ISU-Research/Hydra1-Orbital-Greenhouse/Raw images/Ground/Img-2018-12-22 05_48_20.033600.png

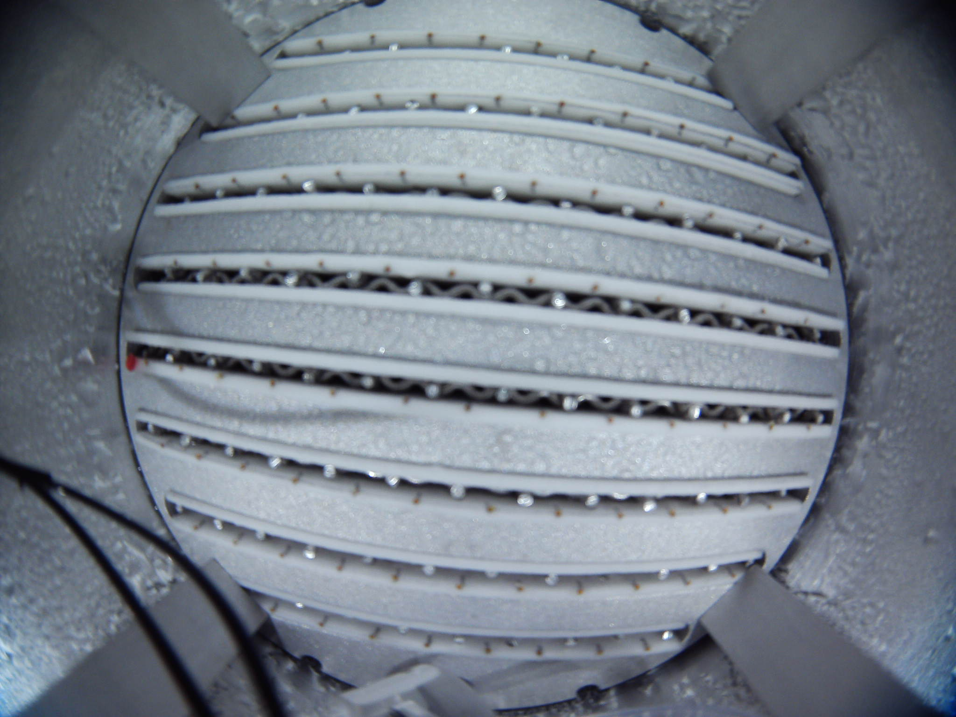
Raw images/Ground/Img-2018-12-22 05_48_20.033600.png
