ISU-Research/Hydra1-Orbital-Greenhouse/Publication/Supplementary figure 1.docx

Supplementary figure 1. The greenness index was calculated for samples of the metal cassette and filter paper to verify that the trends observed for the leaves were not due to imaging factors. The trends are flat but there is a small difference between the transgenic and wildtype values. The direction of this difference is opposite in the ground and flight cubes and may be a result of the asymmetry in the PCB design.
