ISU-Research/Hydra1-Orbital-Greenhouse/Engineering files/Hydra 1 PCB files/Electrical connections inside the cube.pdf

Electrical connections inside the cube

This document details the connection between hermetically sealed connector and the Fisher electronic connector on the PCB.

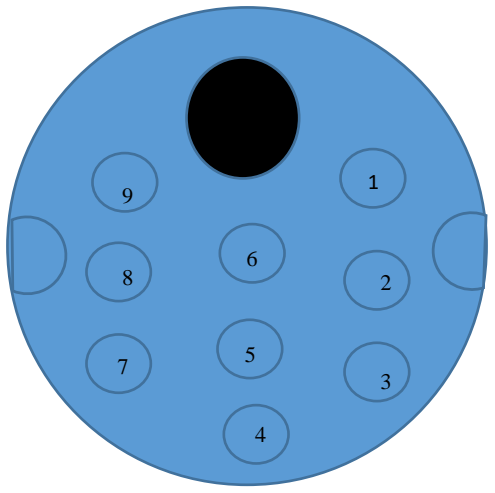
[picture p8: figure]

Figure 1 Front View of the hermitically sealed connector.

Table below enlists the connection.

Pin1 | 5V
Pin 2 | DM
Pin3 | DP
Pin4 | GND
Pin5 | 3.3 V
Pin6 | Temperature Sensor
Pin7 | Valve
1 | 2 3 | 4 | 5 | 6 7 | 9 | 8 | NC

Figure 2 Fisher electronic male connector in out

Pin 8 | Growth LED
Pin 9 | White LED

Table below lists the connection for four pin header

Pin 1 | GND
Pin 2 | DP
Pin 3 | DM
Pin 4 | 5V

Figure below illustrates the orientation of the Header P1 and camera Header

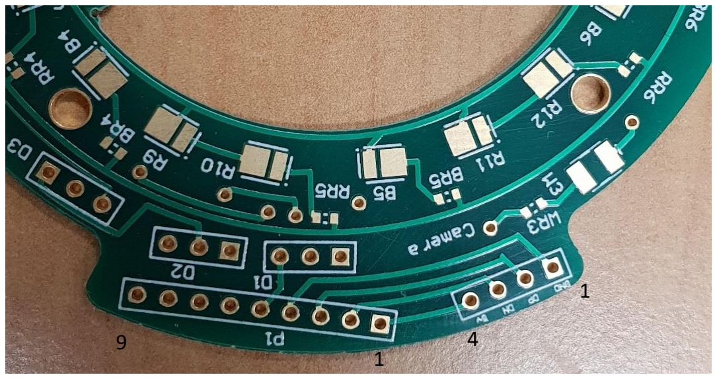
[picture p9: figure]
