ISU-Research/Hydra1-Orbital-Greenhouse/Image analysis/Flight/flight_mask.png

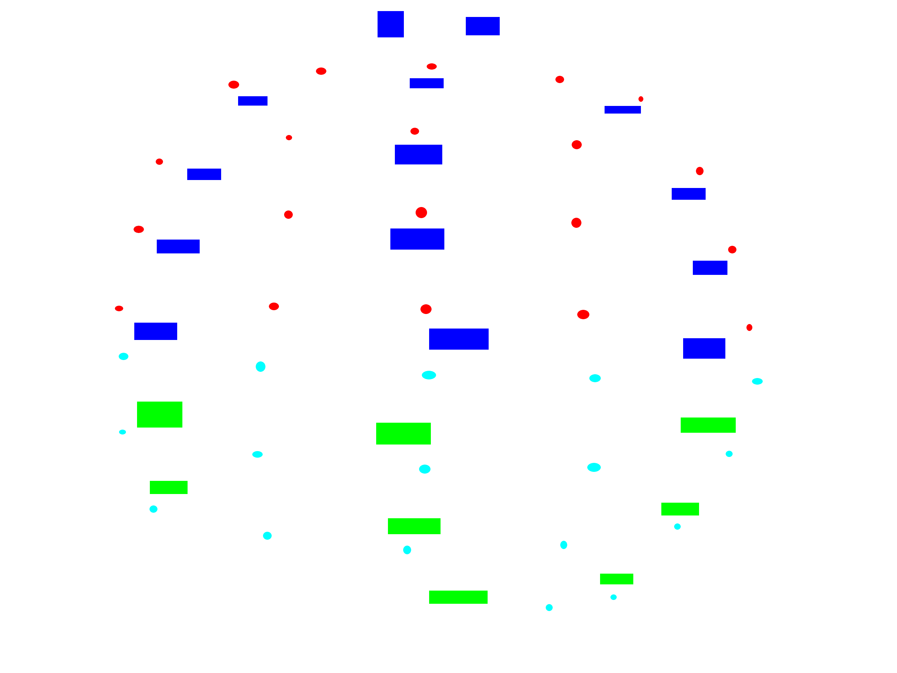
Image analysis/Flight/flight_mask.png
