ISU-Research/Hydra1-Orbital-Greenhouse/Image analysis/Flight/Img-2018-12-24 01_41_35.710161_paste.png

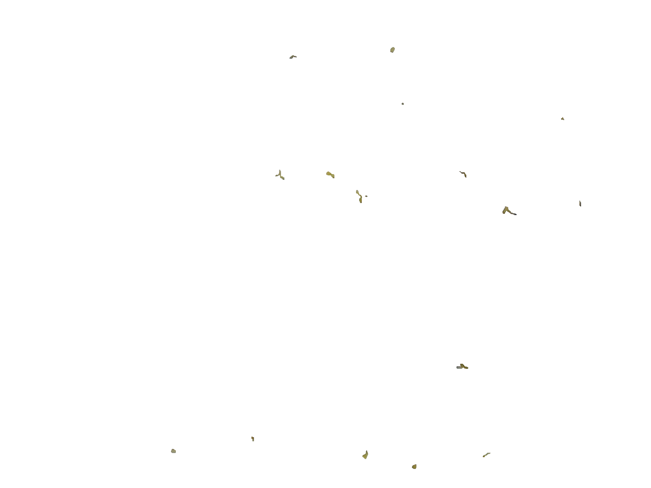
Image analysis/Flight/Img-2018-12-24 01_41_35.710161_paste.png
