ISU-Research/Hydra1-Orbital-Greenhouse/Image analysis/Flight/Img-2018-12-24 17_42_14.649429_paste.png

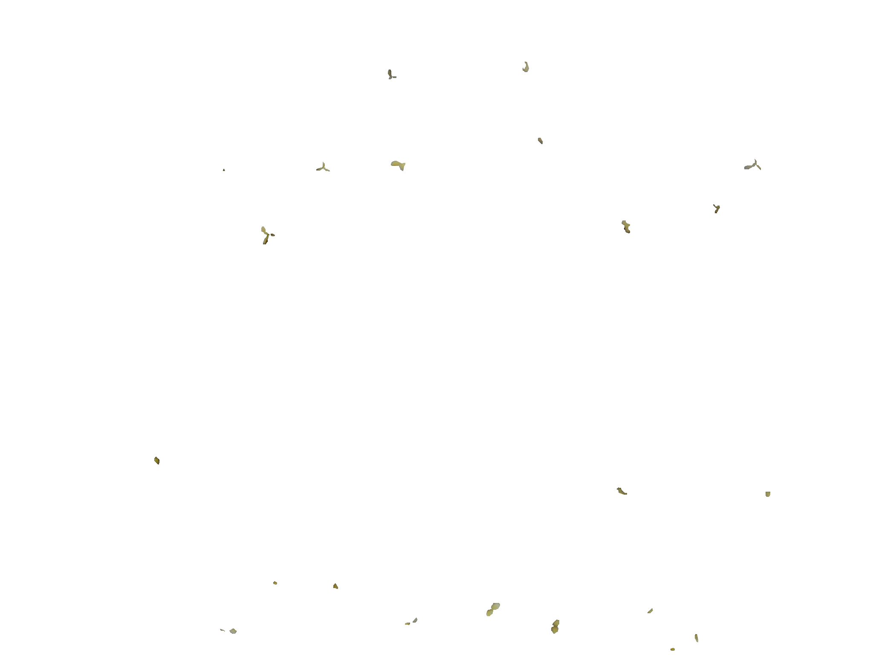
Image analysis/Flight/Img-2018-12-24 17_42_14.649429_paste.png
