ISU-Research/Hydra1-Orbital-Greenhouse/Image analysis/Flight/Img-2018-12-25 09_42_54.447066_paste.png

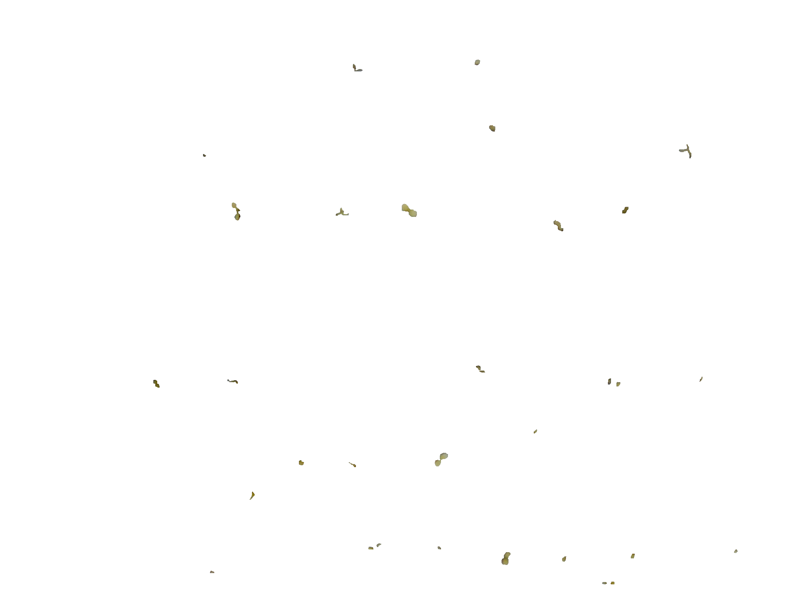
Image analysis/Flight/Img-2018-12-25 09_42_54.447066_paste.png
