ISU-Research/Hydra1-Orbital-Greenhouse/Image analysis/Flight/Img-2018-12-26 01_43_33.579234_paste.png

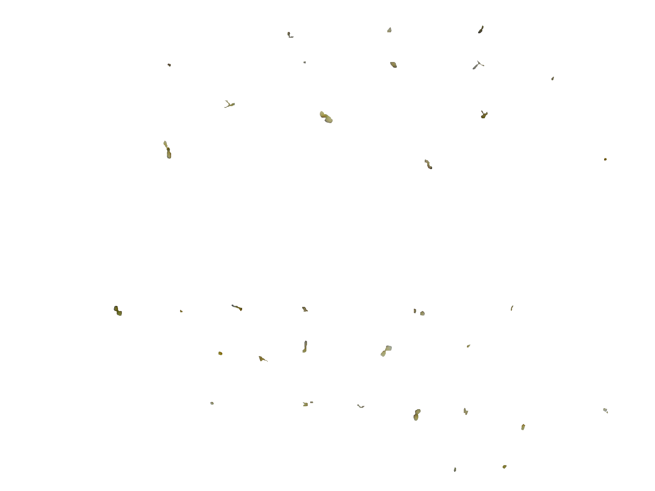
Image analysis/Flight/Img-2018-12-26 01_43_33.579234_paste.png
