ISU-Research/Hydra1-Orbital-Greenhouse/Image analysis/Flight/Img-2018-12-26 17_44_12.587626_paste.png

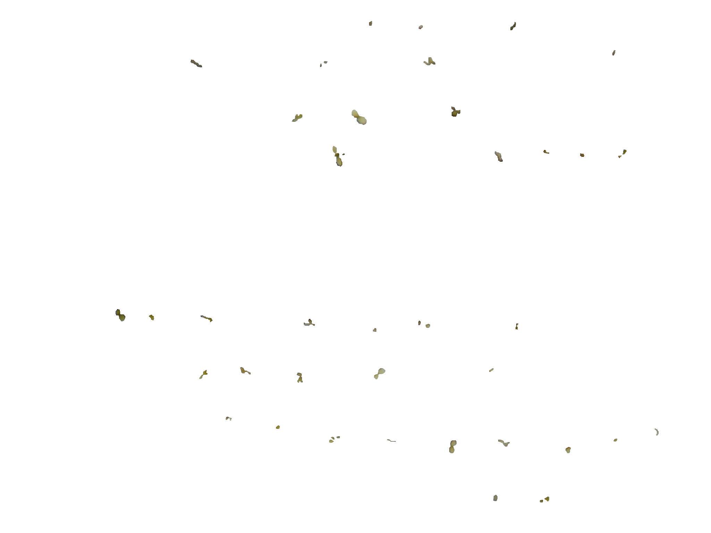
Image analysis/Flight/Img-2018-12-26 17_44_12.587626_paste.png
