ISU-Research/Hydra1-Orbital-Greenhouse/Image analysis/Flight/Img-2018-12-27 09_44_51.706000_paste.png

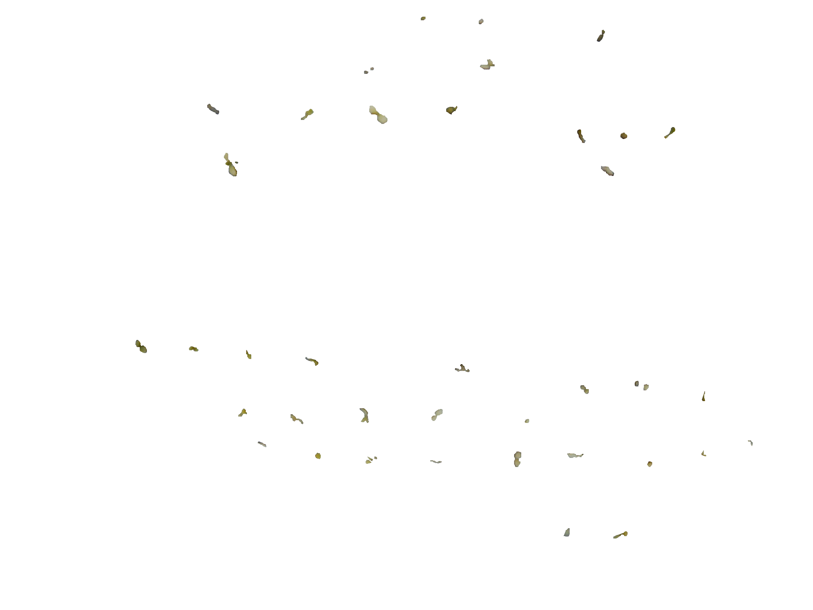
Image analysis/Flight/Img-2018-12-27 09_44_51.706000_paste.png
