ISU-Research/Hydra1-Orbital-Greenhouse/Image analysis/Flight/Img-2018-12-28 03_44_28.547468_paste_notused.png

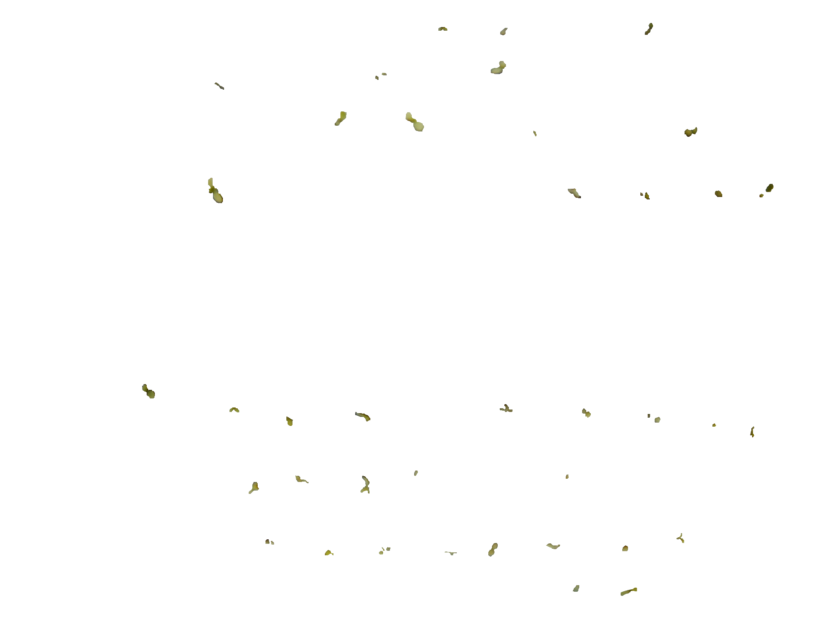
Image analysis/Flight/Img-2018-12-28 03_44_28.547468_paste_notused.png
