ISU-Research/Hydra1-Orbital-Greenhouse/Image analysis/Flight/Img-2018-12-28 19_45_07.533330_paste.png

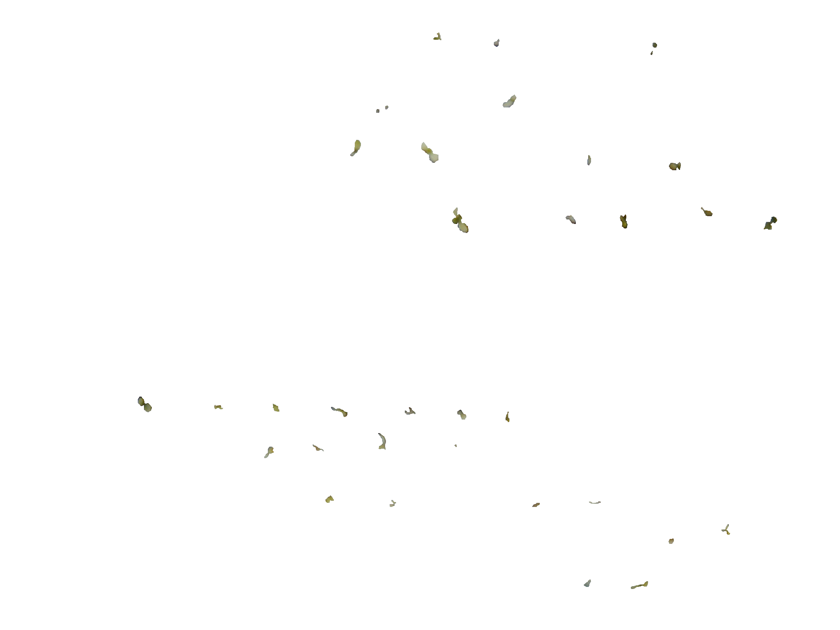
Image analysis/Flight/Img-2018-12-28 19_45_07.533330_paste.png
