ISU-Research/Hydra1-Orbital-Greenhouse/Image analysis/Flight/Img-2018-12-29 11_45_46.413167_paste.png

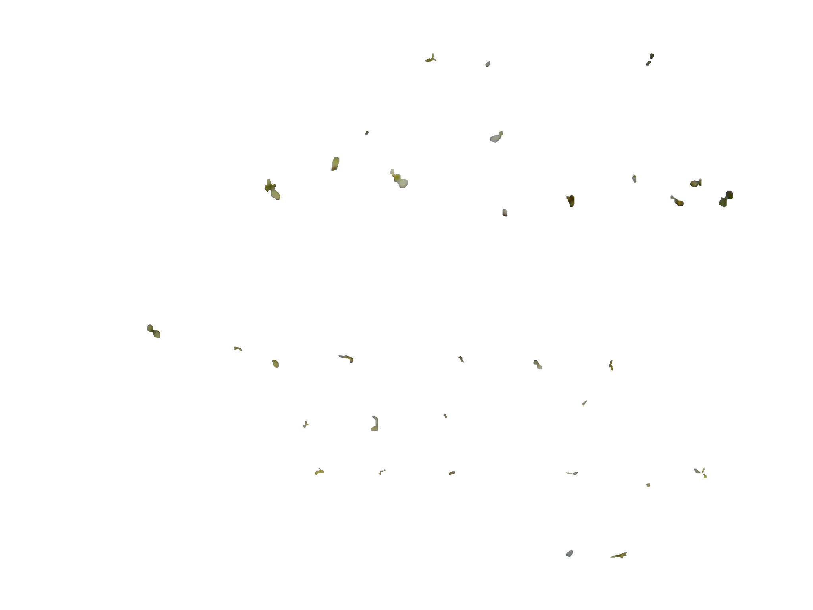
Image analysis/Flight/Img-2018-12-29 11_45_46.413167_paste.png
