ISU-Research/Hydra1-Orbital-Greenhouse/Image analysis/Flight/Img-2018-12-30 03_46_25.447414_paste.png

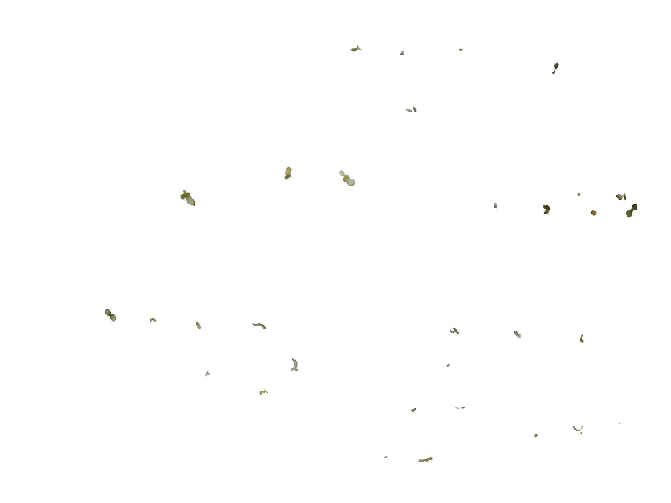
Image analysis/Flight/Img-2018-12-30 03_46_25.447414_paste.png
