ISU-Research/Hydra1-Orbital-Greenhouse/Image analysis/Flight/Img-2018-12-30 19_47_04.819480_paste.png

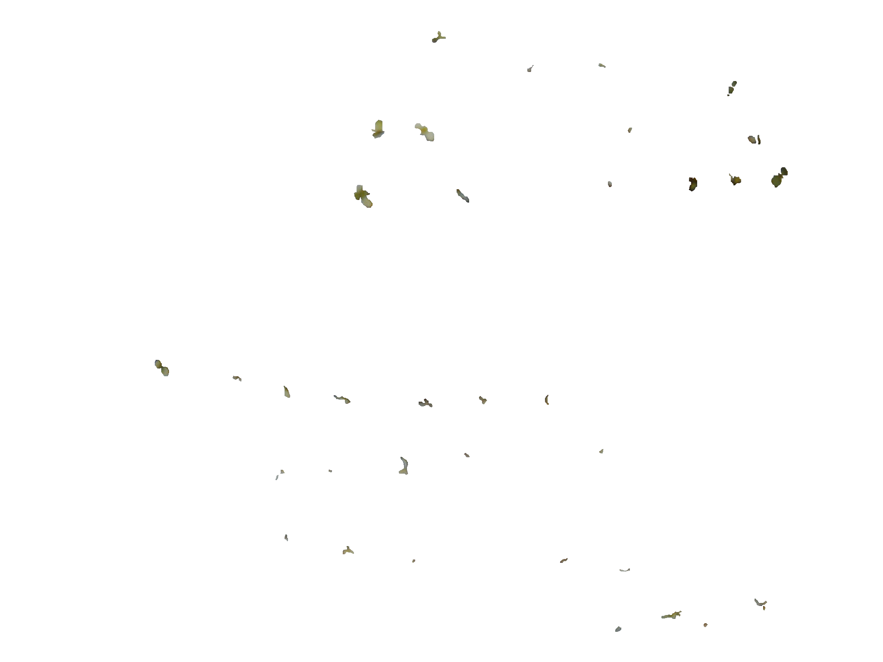
Image analysis/Flight/Img-2018-12-30 19_47_04.819480_paste.png
