ISU-Research/Hydra1-Orbital-Greenhouse/Image analysis/Flight/Img-2018-12-31 11_47_43.694978_paste.png

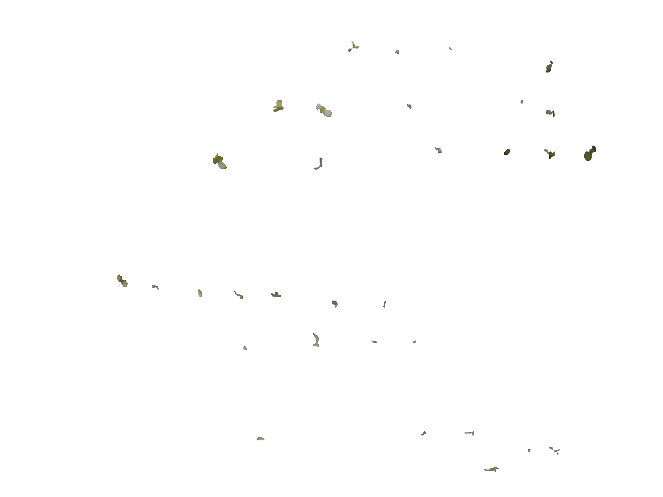
Image analysis/Flight/Img-2018-12-31 11_47_43.694978_paste.png
