ISU-Research/Hydra1-Orbital-Greenhouse/Image analysis/Flight/Img-2019-01-01 03_48_23.416662_paste.png

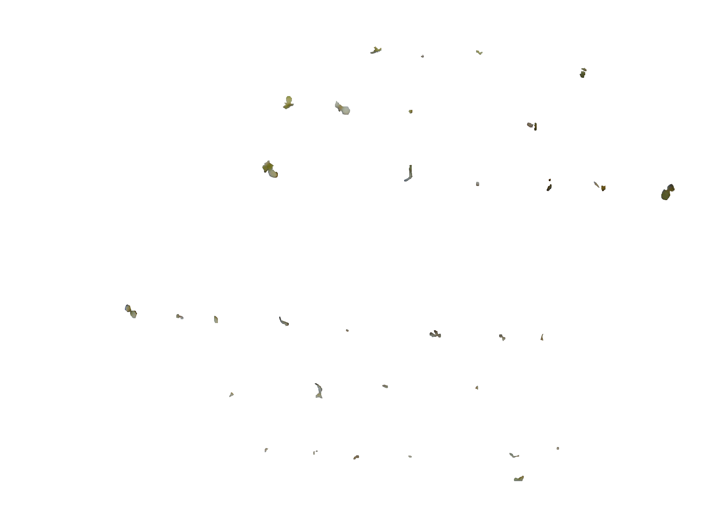
Image analysis/Flight/Img-2019-01-01 03_48_23.416662_paste.png
