ISU-Research/Hydra1-Orbital-Greenhouse/Image analysis/Flight/Img-2019-01-01 19_49_02.385750_paste.png

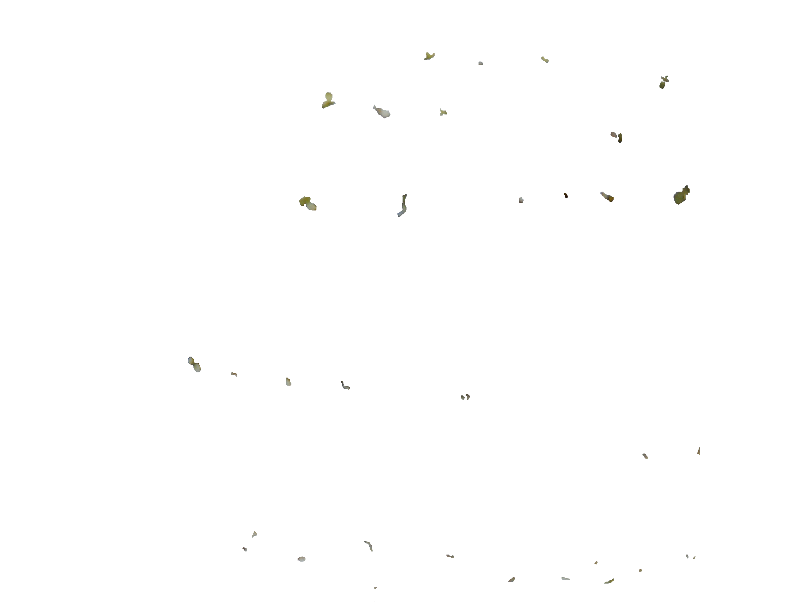
Image analysis/Flight/Img-2019-01-01 19_49_02.385750_paste.png
