ISU-Research/Hydra1-Orbital-Greenhouse/Image analysis/Flight/Img-2019-01-02 11_49_42.058467_paste.png

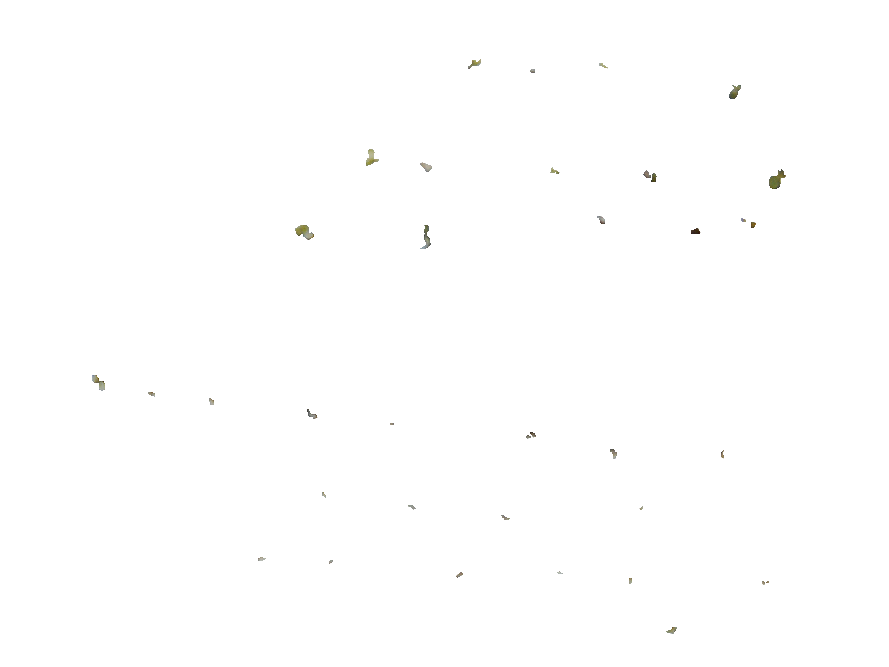
Image analysis/Flight/Img-2019-01-02 11_49_42.058467_paste.png
