ISU-Research/Hydra1-Orbital-Greenhouse/Image analysis/Flight/Img-2019-01-03 03_50_21.868312_paste.png

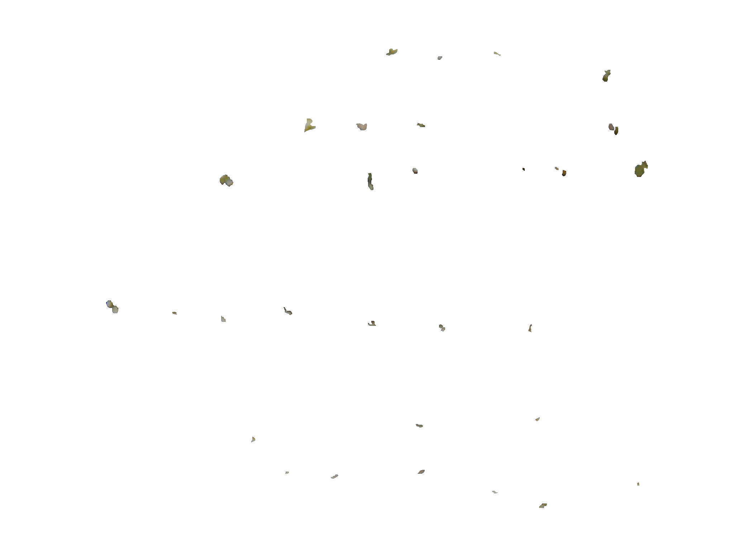
Image analysis/Flight/Img-2019-01-03 03_50_21.868312_paste.png
