ISU-Research/Hydra1-Orbital-Greenhouse/Image analysis/Flight/Img-2019-01-03 19_51_01.522348_paste.png

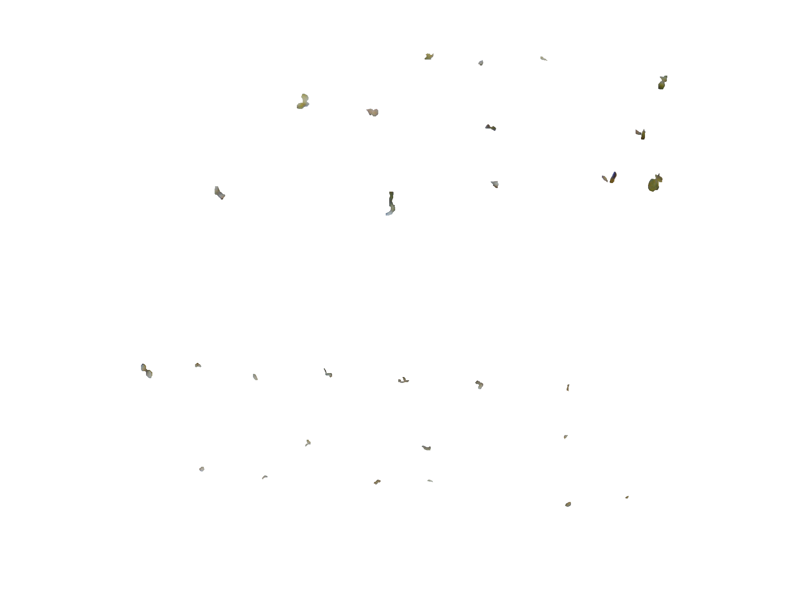
Image analysis/Flight/Img-2019-01-03 19_51_01.522348_paste.png
