ISU-Research/Hydra1-Orbital-Greenhouse/Image analysis/Flight/Img-2019-01-04 11_51_40.223993_paste.png

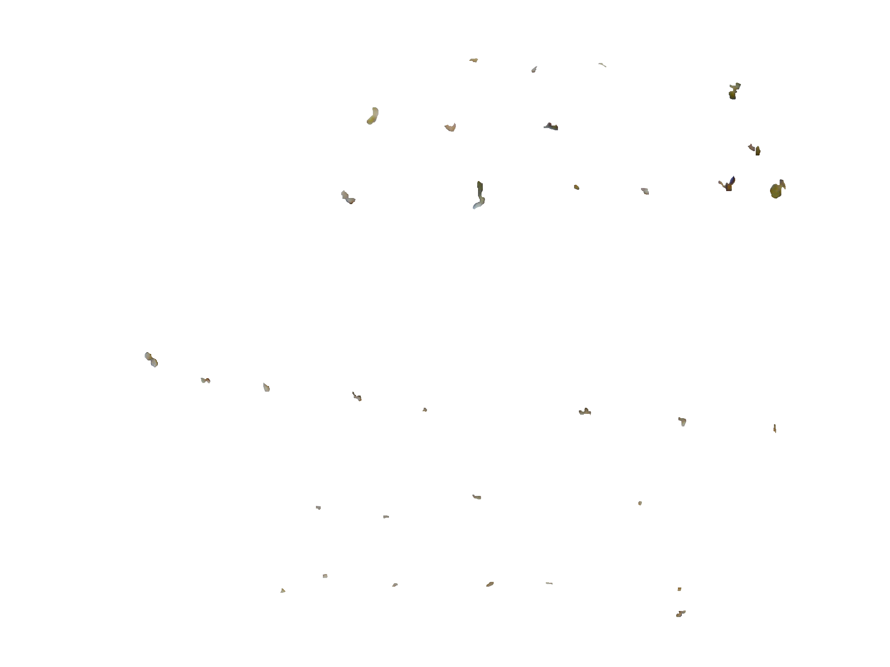
Image analysis/Flight/Img-2019-01-04 11_51_40.223993_paste.png
