ISU-Research/Hydra1-Orbital-Greenhouse/Image analysis/Flight/Img-2019-01-05 20_11_28.602960_paste.png

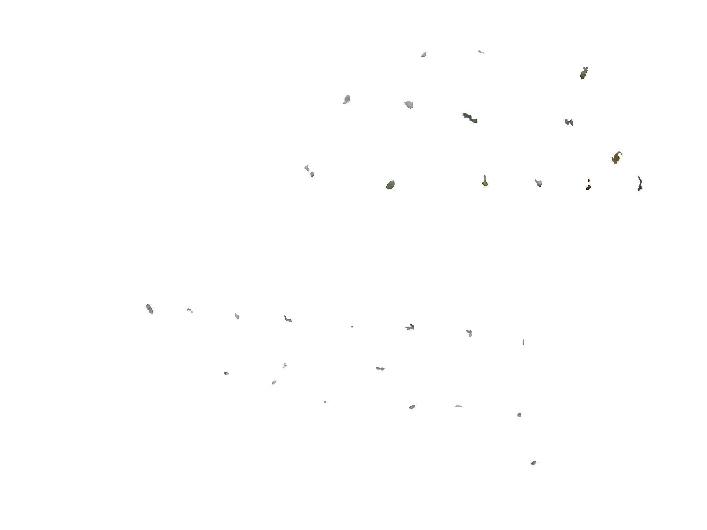
Image analysis/Flight/Img-2019-01-05 20_11_28.602960_paste.png
