ISU-Research/Hydra1-Orbital-Greenhouse/Image analysis/Flight/Img-2019-01-06 12_12_07.463971_paste.png

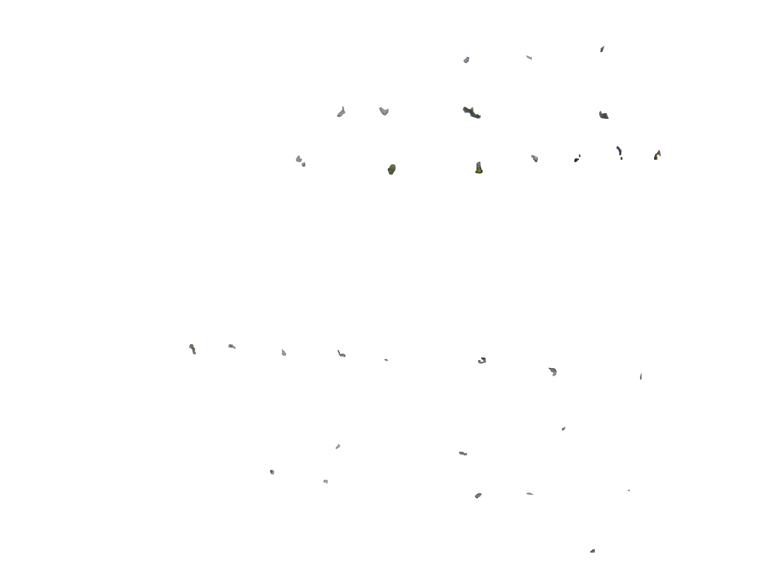
Image analysis/Flight/Img-2019-01-06 12_12_07.463971_paste.png
