ISU-Research/Hydra1-Orbital-Greenhouse/Image analysis/Flight/Img-2019-01-07 04_12_46.611331_paste.png

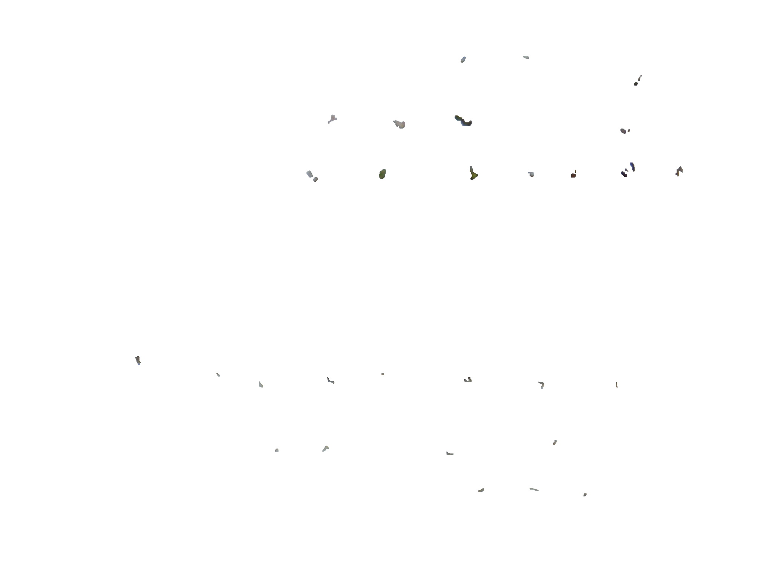
Image analysis/Flight/Img-2019-01-07 04_12_46.611331_paste.png
