ISU-Research/Hydra1-Orbital-Greenhouse/Image analysis/Ground/ground_mask.png

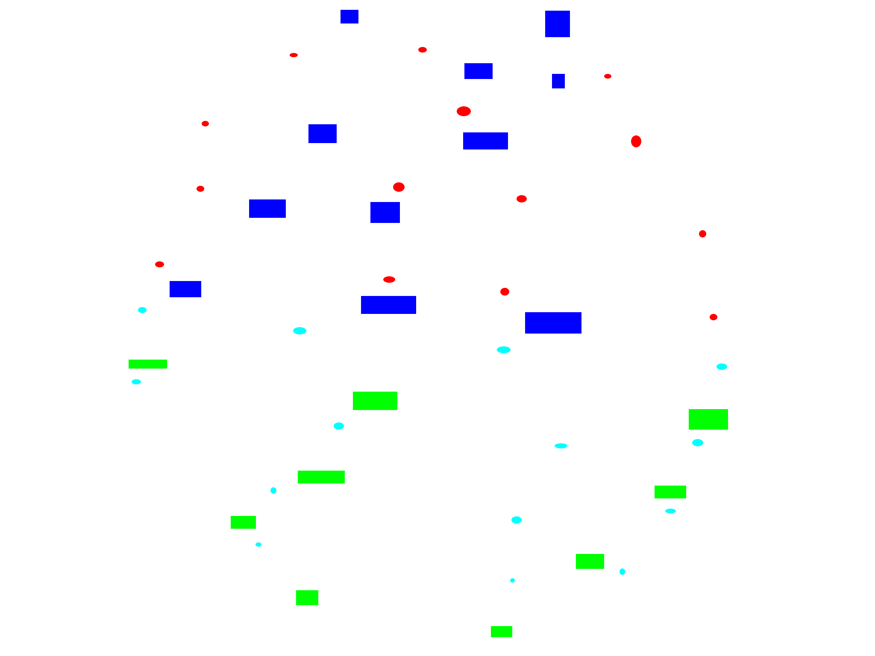
Image analysis/Ground/ground_mask.png
