ISU-Research/Hydra1-Orbital-Greenhouse/Image analysis/Ground/Img-2018-12-23 21_48_47.273996_paste.png

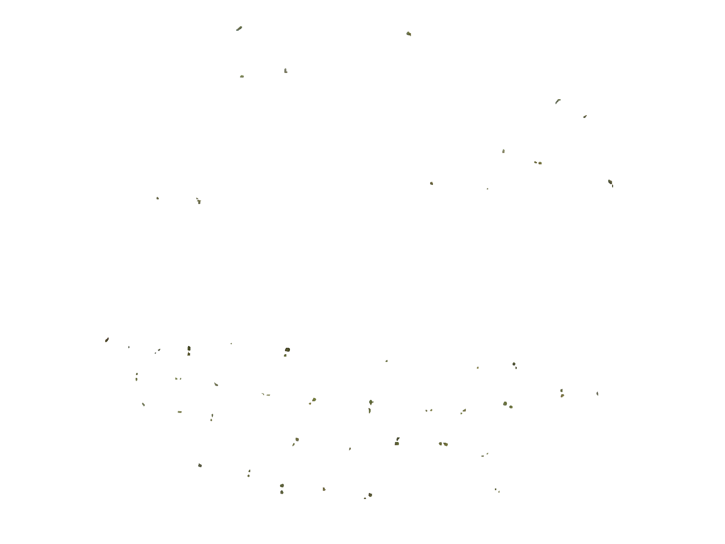
Image analysis/Ground/Img-2018-12-23 21_48_47.273996_paste.png
