ISU-Research/Hydra1-Orbital-Greenhouse/Image analysis/Ground/Img-2018-12-24 13_48_58.081241_paste.png

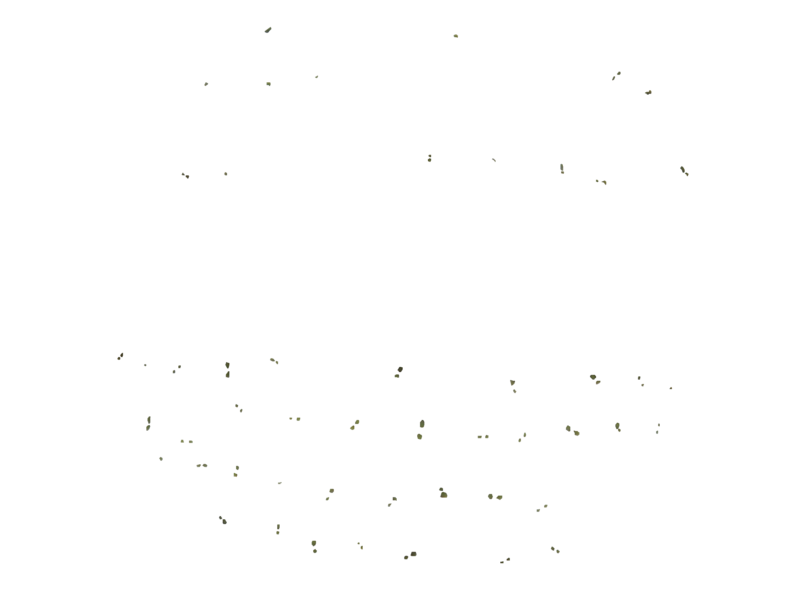
Image analysis/Ground/Img-2018-12-24 13_48_58.081241_paste.png
