ISU-Research/Hydra1-Orbital-Greenhouse/Image analysis/Ground/Img-2018-12-25 05_49_09.011679_paste.png

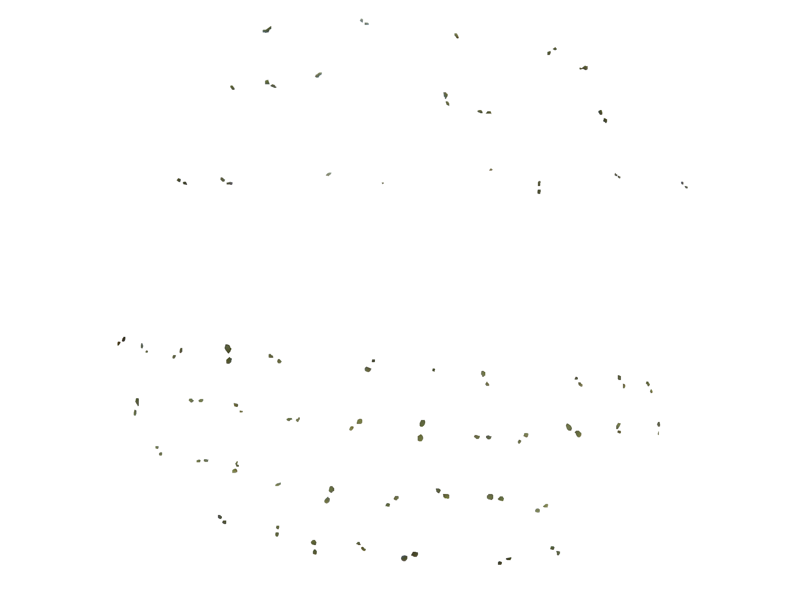
Image analysis/Ground/Img-2018-12-25 05_49_09.011679_paste.png
