ISU-Research/Hydra1-Orbital-Greenhouse/Image analysis/Ground/Img-2018-12-25 21_49_19.136099_paste.png

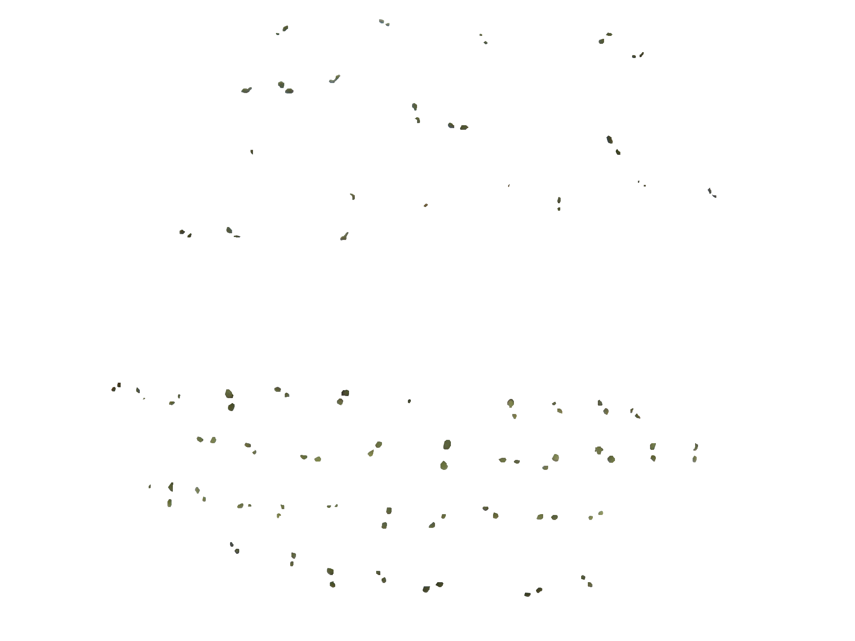
Image analysis/Ground/Img-2018-12-25 21_49_19.136099_paste.png
