ISU-Research/Hydra1-Orbital-Greenhouse/Image analysis/Ground/Img-2018-12-26 13_49_30.211937_paste.png

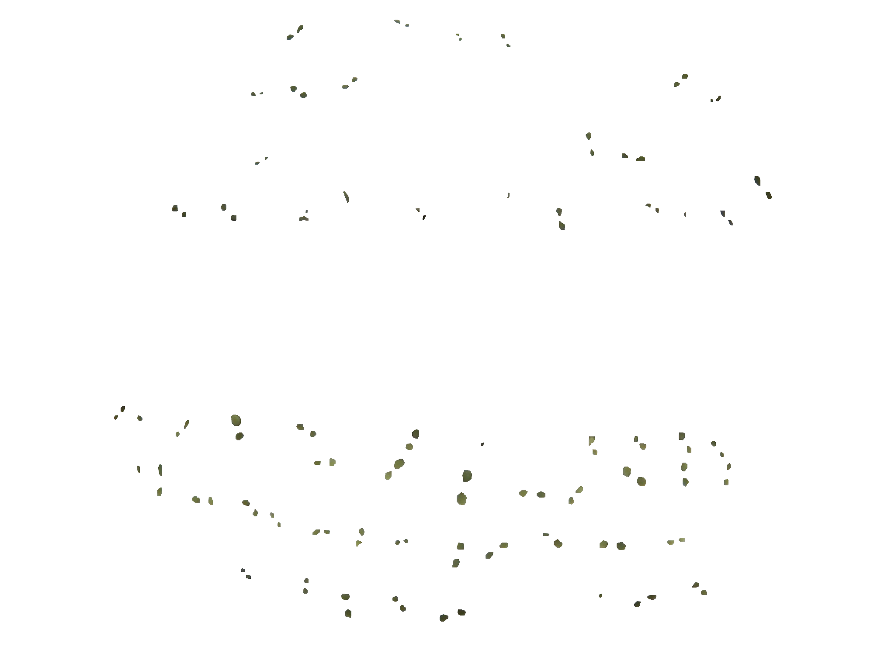
Image analysis/Ground/Img-2018-12-26 13_49_30.211937_paste.png
