ISU-Research/Hydra1-Orbital-Greenhouse/Image analysis/Ground/Img-2018-12-27 05_49_41.395611_paste.png

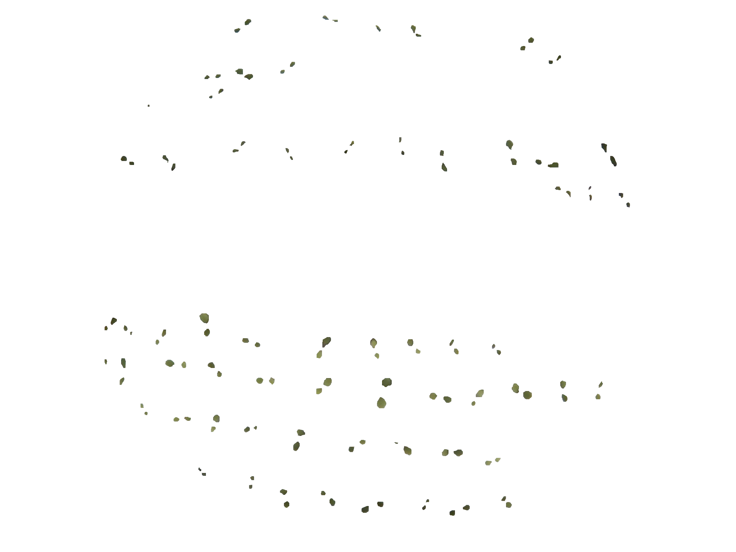
Image analysis/Ground/Img-2018-12-27 05_49_41.395611_paste.png
