ISU-Research/Hydra1-Orbital-Greenhouse/Image analysis/Ground/Img-2018-12-27 21_49_57.605890_notused.png

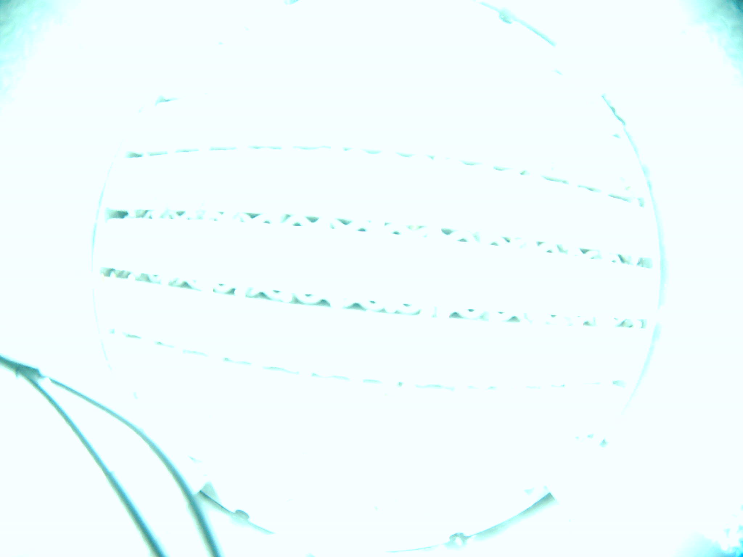
Image analysis/Ground/Img-2018-12-27 21_49_57.605890_notused.png
