ISU-Research/Hydra1-Orbital-Greenhouse/Image analysis/Ground/Img-2018-12-28 15_02_47.237986_paste.png

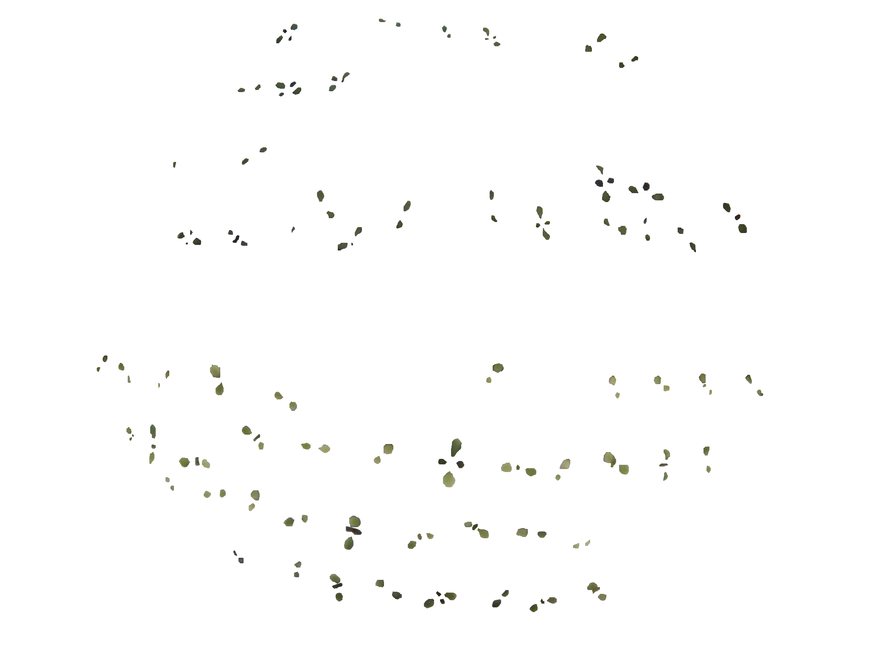
Image analysis/Ground/Img-2018-12-28 15_02_47.237986_paste.png
