ISU-Research/Hydra1-Orbital-Greenhouse/Image analysis/Ground/Img-2018-12-29 08_54_56.624475_paste.png

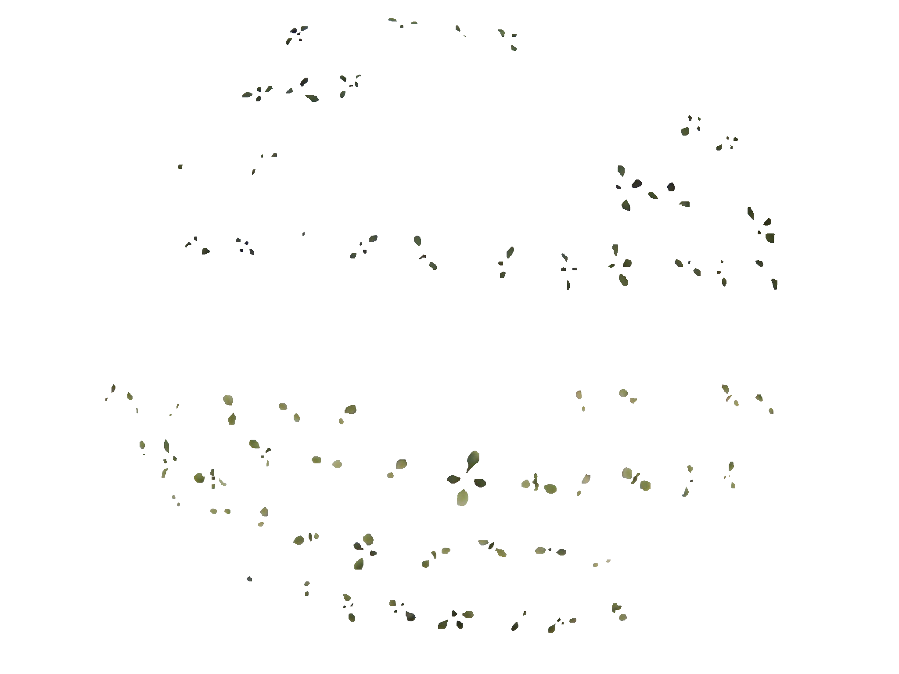
Image analysis/Ground/Img-2018-12-29 08_54_56.624475_paste.png
