ISU-Research/Hydra1-Orbital-Greenhouse/Image analysis/Ground/Img-2018-12-30 00_55_05.835713_paste.png

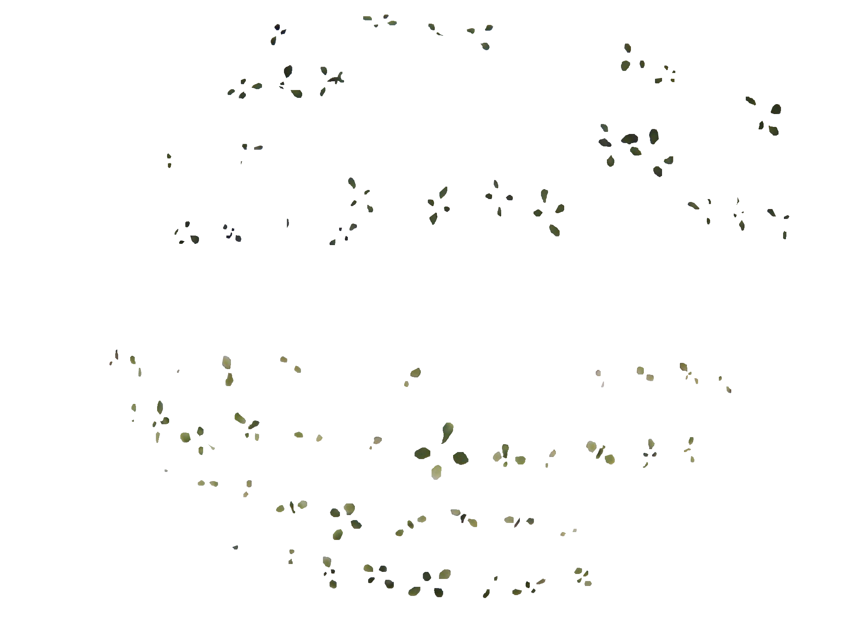
Image analysis/Ground/Img-2018-12-30 00_55_05.835713_paste.png
