ISU-Research/Hydra1-Orbital-Greenhouse/Image analysis/Ground/Img-2018-12-30 16_55_15.043159.png

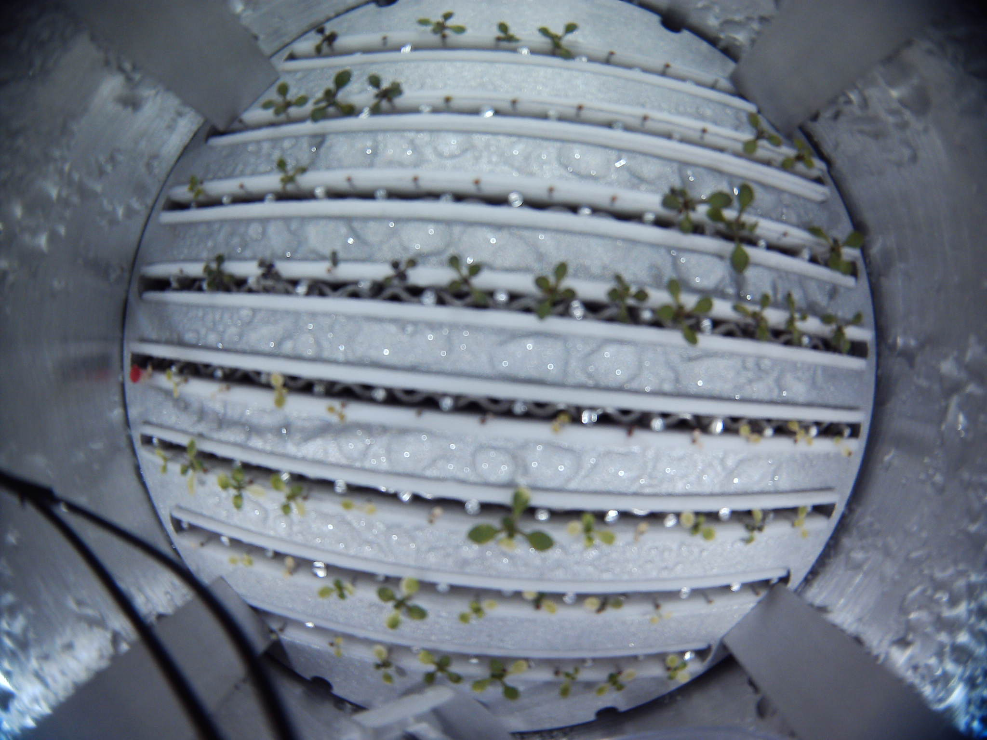
Image analysis/Ground/Img-2018-12-30 16_55_15.043159.png
