ISU-Research/Hydra1-Orbital-Greenhouse/Image analysis/Ground/Img-2018-12-31 08_55_24.249260_paste.png

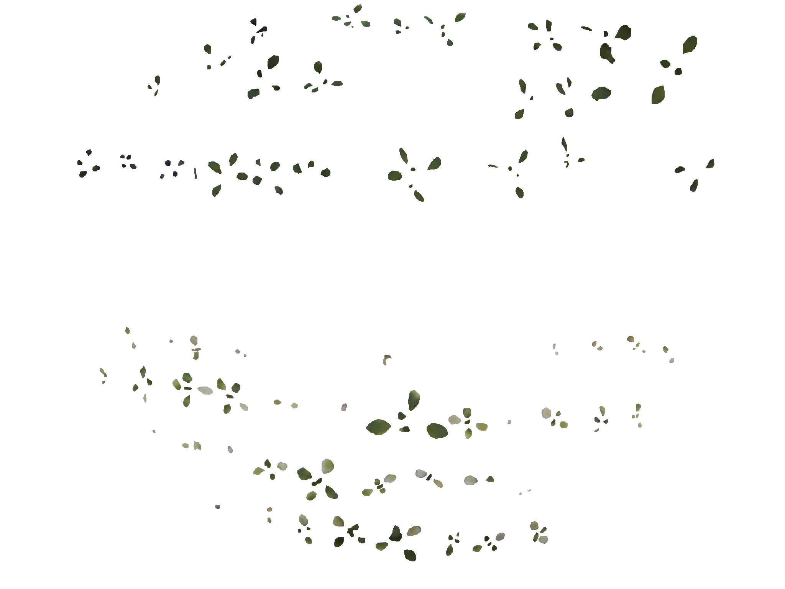
Image analysis/Ground/Img-2018-12-31 08_55_24.249260_paste.png
