ISU-Research/Hydra1-Orbital-Greenhouse/Image analysis/Ground/Img-2019-01-01 00_55_33.471429_paste.png

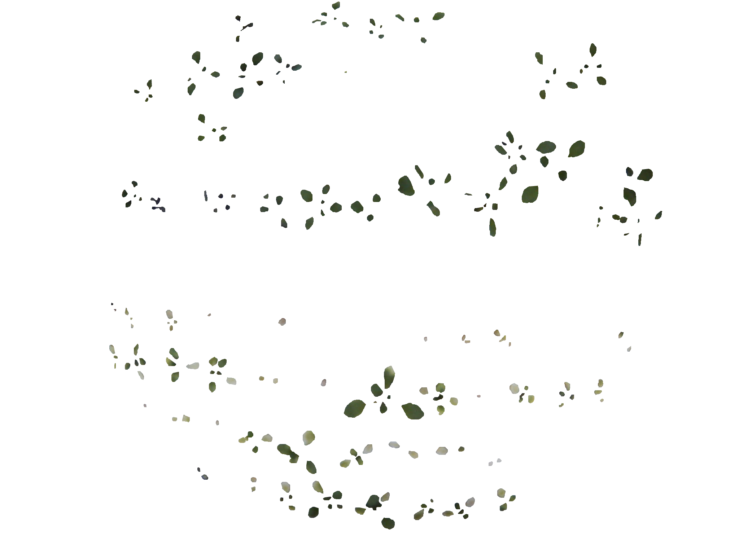
Image analysis/Ground/Img-2019-01-01 00_55_33.471429_paste.png
