ISU-Research/Hydra1-Orbital-Greenhouse/Image analysis/Ground/Img-2019-01-01 16_55_42.704226.png

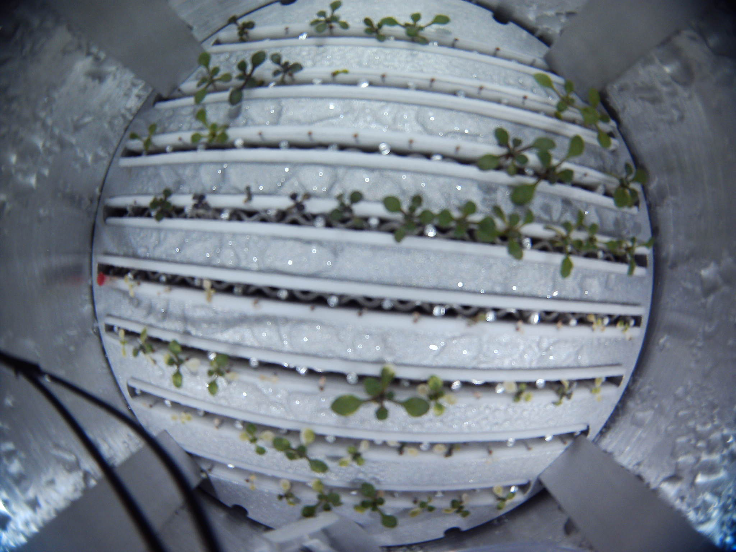
Image analysis/Ground/Img-2019-01-01 16_55_42.704226.png
