ISU-Research/Hydra1-Orbital-Greenhouse/Image analysis/Ground/Img-2019-01-02 08_55_56.453749_paste.png

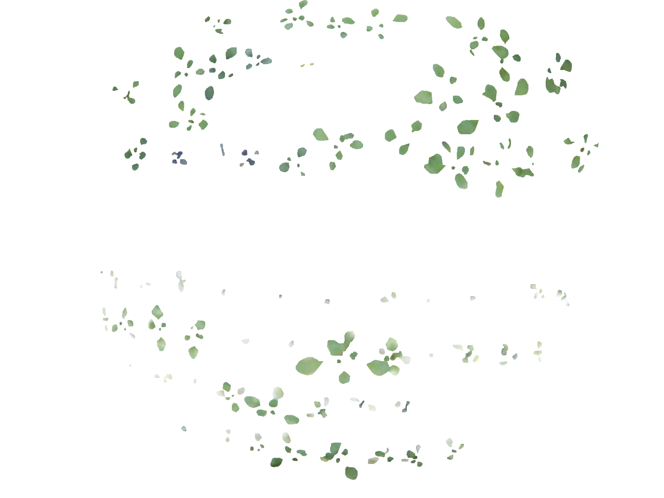
Image analysis/Ground/Img-2019-01-02 08_55_56.453749_paste.png
