ISU-Research/Hydra1-Orbital-Greenhouse/Raw images/Flight/Img-2018-12-27 15_44_00.441396.png

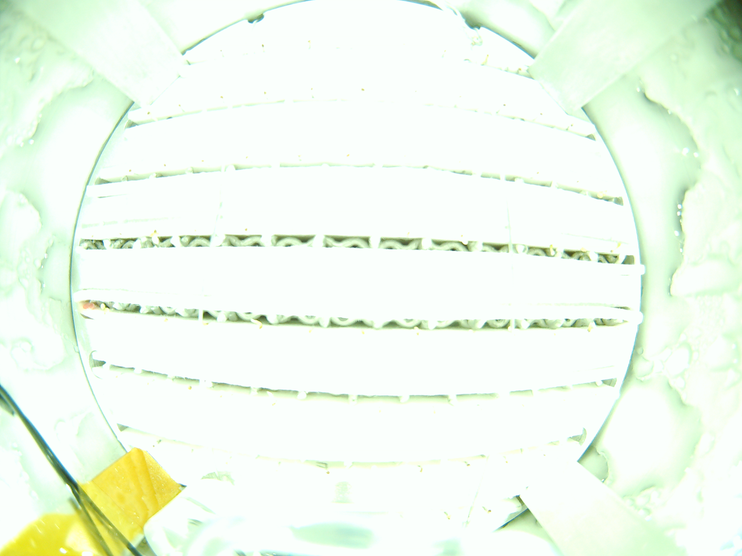
Raw images/Flight/Img-2018-12-27 15_44_00.441396.png
