ISU-Research/Hydra1-Orbital-Greenhouse/Raw images/Ground/Img-2018-12-25 09_49_11.966990.png

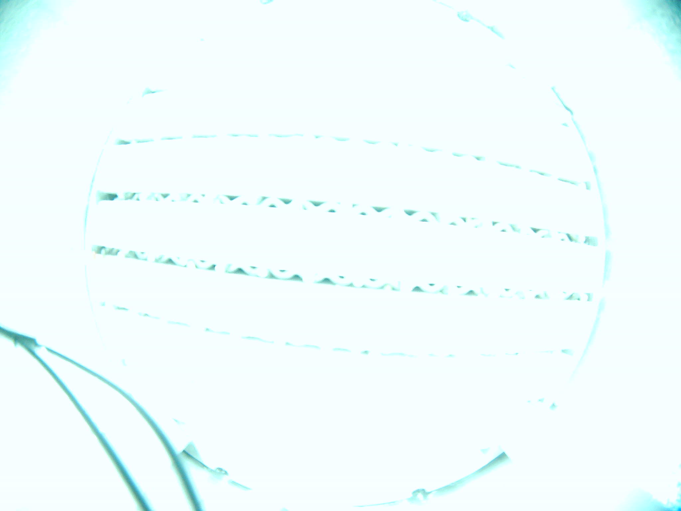
Raw images/Ground/Img-2018-12-25 09_49_11.966990.png
