ISU-Research/Hydra1-Orbital-Greenhouse/Raw images/Ground/Img-2019-01-02 00_55_47.458617.png

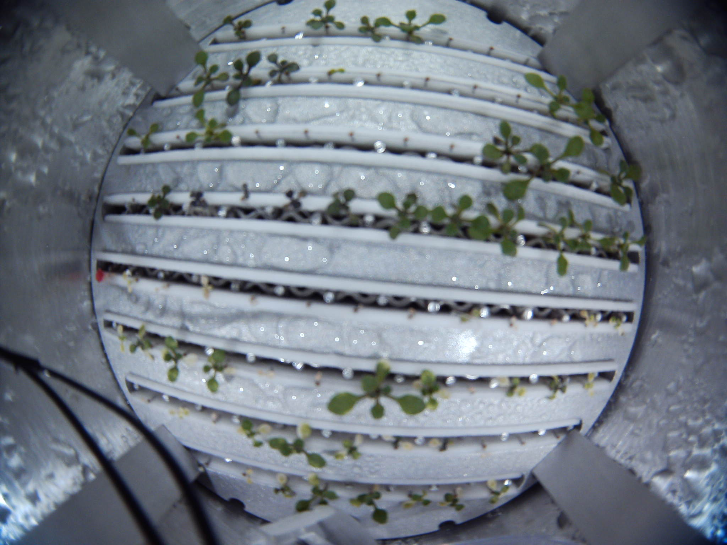
Raw images/Ground/Img-2019-01-02 00_55_47.458617.png
