ISU-Research/Hydra1-Orbital-Greenhouse/Raw images/Ground/Img-2019-01-02 04_55_54.771255.png

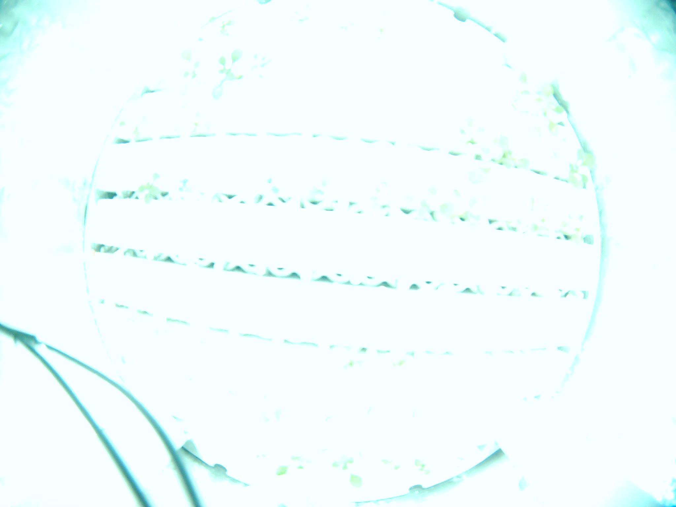
Raw images/Ground/Img-2019-01-02 04_55_54.771255.png
