ISU-Research/Hydra1-Orbital-Greenhouse/Raw images/Ground/Img-2019-01-02 16_56_01.036330.png

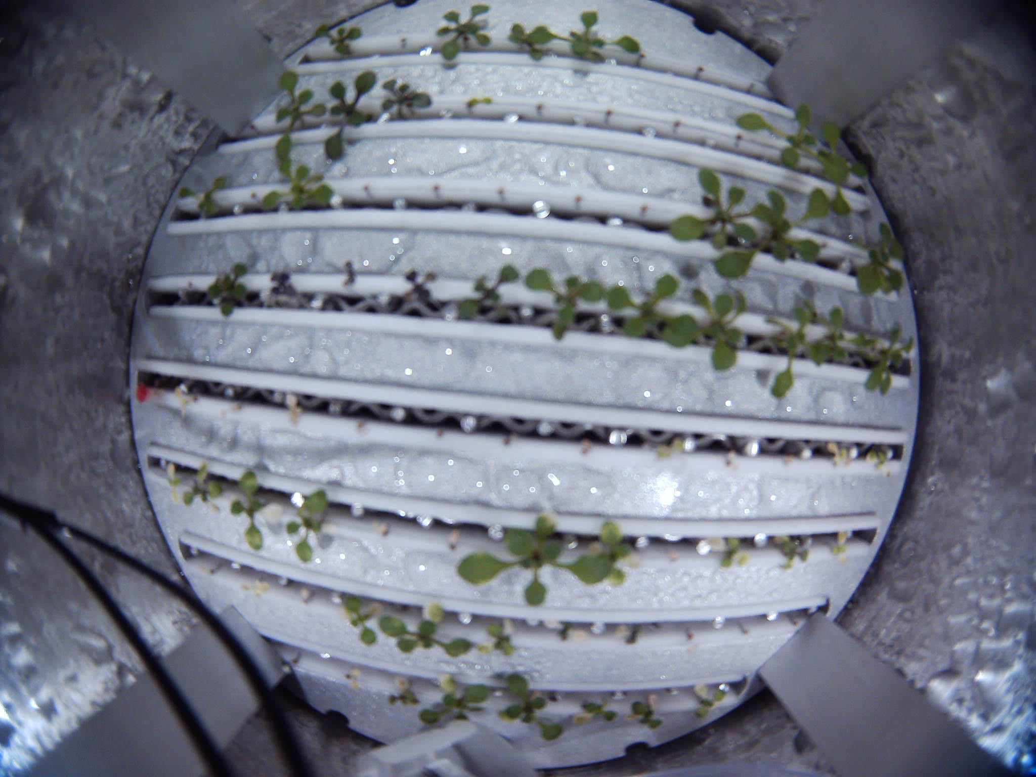
Raw images/Ground/Img-2019-01-02 16_56_01.036330.png
