ISU-Research/Hydra1-Orbital-Greenhouse/Engineering files/Hydra 1 safety data inputs/ICE-Cubes-Materials-List-Hyrda-1- 23 May 2018 MFH.xlsx

Sheet: DML
Number | Commercial identification | Chemical nature | Manufacturer & Specifications | Processing parameters | Use & Location | Radiation | Ambience | Temperature | Size | Corrosion | SCC | Flammability | Offgassing | Outgassing | Justification & Comments
1 | 2 | 3 | 4 | 5 | 6 | 7R | 7A | 7T | 8 | 9C | 9S | 9F | 9O | 9U | 10
01.01 | Aluminum | AL 6061 | Fabrication: Heat Treated Temper: T6511 Temper Rating: Hardened Hardness: Brinell 95 Hardness Rating: Soft Heat Treatable: Yes Temperature Range: -320° to 300° F Specifications Met ASTM B221 |  | Structure, lid, camera support, spring plate. | L | M | 3/4 | M4 | B | A | N/A |  |  | MAPTIS
5.01 | Metal Spring | Carbon steel SAE 1070-1090 | Part No. CM60-L7, Spring type: crest-to-crets, Bore: 60 mm, Shaft diameter: 50 mm, Load: 135 N, Working height: 16.39 mm, Free height: 34.29 mm, Spring rate: 7.71 N/mm. |  | Pressurizes water bag | L | M | 3/4 | M2 | B | A | N/A |  |  | MAPTIS
6.01 | Screws | 316 Stainless Steel | Super-Corrosion-Resistant 316 Stainless Steel Socket Head Screws sizes: M4 x 0.7 mm Thread, 12 mm Long, M3 x 0.5 mm Thread, 8 mm Long, M2 x 0.4 mm Thread, 4 mm Long and 316 Stainless Steel Belleville Spring Lock Washer for M4 and M3 screws. |  | Holds top of the chamber | L | M | 3/4 | M2 | A | B | N/A |  |  | MAPTIS
16.01 | O ring | Oil-Resistant Buna-N | 3 mm Wide, 86 mm ID. Buna-N Rubber, Cross Section Shape Round Width 3 mm ID 86 mm OD 92 mm Hardness Durometer 70A (Medium) |  | Airtight seal for the lid | L | M | 3/4 | M3 | A | A | N/A |  |  | MAPTIS
13.01 | Lubricant for O ring | Stopcock grease | Corning Silicone stopcock grease |  | Airtight seal for the lid | L | M | 3/4 | M3 | A | A | N/A |  |  | On previouls ISS plant experiments
 | Solenoid valve |  | Part No. LHDA0531515H, Voltage: 5 VDC, Power: 850 mW, Operating pressure: 0-15 PSID [0-103 kPad] VAC-45 PSIG [VAC-310 kPag], Flow capacity: 1500 LOHMS NOM (4.4 LPM@10 PSIG) |  | Controls water release | L | M | 3/4 | M2 | A | A | N/A |  |  | MAPTIS
 | Steel support rods |  |  |  | thin rods the run through the Delrin plant growth platform to secure the pieces | L | M | 3/4 | M4 | A | A | N/A |  |  | MAPTIS
 | Camera |  |  |  | Images | L | M | 3/4 | M3 | A | A | N/A
 | Camera wiring USB |  |  |  | wires | L | M | 3/4 | M2 | N/A | A | N/A
 | LEDs |  |  |  | light source | L | M | 3/4 | M2 | N/A | N/A | A
 | LED wiring |  |  |  | wires | L | M | 3/4 | M2 | N/A | N/A | A
 | Solenoid valve wiring |  |  |  | wires | L | M | 3/4 | A3 | N/A | N/A | A
 | Electrical passthrough |  |  |  | wire passthrough | L | M | 3/4 | A3 | N/A | N/A | A
 | Delrin | polyformaldehyde |  |  | Seed support platform | L | M | 3/4 | M3 | N/A | N/A | A |  |  | Delrin has flown on ISS equipment before (Perez-Nunez et al. 2011)
 | Wetting Paper |  | Whatman CH17 Chromatography paper. |  | Plant seed support and wetting material | L | M | 3/4 | M2 | N/A | N/A | F |  |  | On previouls ISS plant experiments
 | Guar Gum |  | Aqua Solutions, Deer Park TX CAS#:9000-30-0 |  | paste used to attach seeds to the paper | L | M | 3/4 | M2 | N/A | N/A | A |  |  | On previouls ISS plant experiments
 | Cheesecloth |  | Cotton cloth |  | Water holding system placed at the base of the plant platform | L | M | 3/4 | M3 | N/A | N/A | A |  |  | On previouls ISS plant experiments
 | Plastic grid | polypropylene |  |  | Holds the seeds in place | L | M | 3/4 | M2 | N/A | N/A | B |  |  | On previouls ISS plant experiments
 | Water bag and tube | Plasticizer DEHP | 50 mL |  | Contains water solution | L | M | 3/4 | M2 | N/A | N/A | F |  |  | On previouls ISS plant experiments
 | Water solution |  |  |  | H2O simple | L | M | 3/4 | M2 | N/A | N/A | A
 | Wetting color indicator dots |  |  |  | Indicate presence of water | L | M | 3/4 | M3 | N/A | N/A | A
 | Temperature indicators |  |  |  | Temperature determination with a passive color indicator | L | M | 3/4 | M2 | N/A | N/A | A
 | Seeds, wild type | Arabidopsis columbia |  |  | These are the seeds for the un-modifed plants and are the control for the experiment | L | M | 3/4 | M2 | N/A | N/A | A |  |  | On previouls ISS plant experiments
 | Seeds, transgenic type | Arabidopsis columbia |  |  | These are the seeds of the genetically altered plants
 | beta-estradiol |  |  |  | Hormone to trigger the stress response in the genetically altered strain. (depends on the seeds used)
 | Dexamethasone |  |  |  | Hormone to trigger the stress response in the genetically altered strain. (depends on the seeds used)
 | Murashige and Skoog Basal Salt Mixture |  | Milipore Sigma (Sigma Aldridge) |  | Standard nutrient solution for plant growth containing mineral salts and organics |  |  |  |  |  |  |  |  |  | On previouls ISS plant experiments

Sheet: Columns Description
Column | Content | Content Description
1 | Item number (applicable to equipment manufacturer level only) X.Y.Z.CODE | X is the group number (between 01 and 20). Y is the identifier within the group. Z is the running number (if needed). CODE is the user code for the project (if needed). Only one per material type. Does not change during the life of the materials list (sub-items are permitted when deemed necessary). If an item is deleted, the number will not be used again.
2 | Commercial identification or standardized designation | Correct and standard designation, such as the trade name plus number. If no trade name exists, manufacturer’s name plus number. For metal alloys, the Aluminium Association (AA) system is recommended for aluminium alloys, and the American Iron and Steel Institute (AISI) system for steel. For other metals or alloys, the main constituent is entered first except in the case of a traditional name (e.g. brass or bronze). For each material, as designated above, a unique item number is used. If several lines are used for different applications or processing, add sub-item numbers.
3 | Chemical nature and product type (e.g. epoxy resin, polyurethane adhesive, Ti6Al4V) | For metallic materials, the condition as procured if applicable is added (e.g. rolled, heat treatment). Where a semi-finished product is procured, the relevant state is given (e.g. form, plate, sheet). Thickness of the material is given, if important.
4 | Procurement information | Manufacturer or distributor: name of the manufacturer and name of the distributor if different. Procurement specification: reference is provided to one of the following: - the procurement specification with issue, revision and date - a national or international specification or standard, if this exists, and identifies the source of procurement (if relevant), with issue, revision and date - datasheets, in which case indication of issue or date is not applicable.
5 | Processing parameters | Summary of the process parameters applied by the user of the process. (e.g. mixture proportions, cure temperature, special cleaning agent, surface treatment, thermal treatment and temperature, and reference to specification number)
6 | Use and location | Identifies in detail the subsystem and location of the materials used (e.g. in accordance with the Product Tree). Use and/or nomenclature of the equipment is added (e.g. structural element, thermal control, wire insulation). Includes any restrictions that apply to the use of a particular material in the corresponding comment column.
7 | Environmental code | Note: For ICE Cubes, L for Low orbit is used, M for Manned and 3/4 for the Temperature range (unless specific susbsystems reach a higher temperature, in which case 3/5 is used).
 |  | R - Radiation/UV/ATOX¹ |  | A - Ambience | T - Temperature² ³
 |  | G: Geostationary | S: Outside shadow | V: Vacuum | 1: 0 to 100 K
 |  | L: Low orbit | L: Outside light | H: Hermetic | 2: 101 to 200 K
 |  | B: Radiation belts |  | M: Manned | 3: 201 to 300 K
 |  | I: Inter-planetary |  | E: Elevated pressure | etc.
 |  | P: Planetary
 |  | ¹ For all materials, a letter is selected from the left-hand column. For materials on the surface of the spacecraft, the letter L or S is added. ² Thermal cycling to be indicated by two values, e.g. 3/5. ³ RT (room temperature) can be accepted as a code between 283 K (10°C) and 313 K (40°C). The materials that are at a boundary between environments are described by two sets of codes.
8 | Size code (i.e. Area in cm², Volume in cm³, and Mass in g) | Indicated by an alphanumeric combination, e.g. A5, V2 or M3, as follows: 0: 0 < A (cm²) or V (cm³) or M (g) ≤ 1 1: 1 < A (cm²) or V (cm³) or M (g) ≤ 10 2: 10 < A (cm²) or V (cm³) or M (g) ≤ 100 3: 100 < A (cm²) or V (cm³) or M (g) ≤ 1000 etc.
9 | Validation references | Reference is made to relevant test data that demonstrates the acceptability of the material under the environmental conditions and the application relevant to the particular project concerned.
 | C: Corrosion | A: Material does not require a surface treatment or coating for its intended application (cf. NASA-STD-6012), otherwise it shall be rated B. B: Details of the surface treatment stated in column 5.
 | S: Stress Corrosion Cracking | A: Material is known to have a high resistance to SCC as per table 5-1 of ECSS-Q-ST-70-36 or per table I of MSFC-STD-3029. B: Material listed in table 5-2 or 5-3 of ECSS-Q-ST-70-36, or table II or III of MSFC-STD-3029. Justification for approval (test reference) stated in column 10. U: Material and/or welds for which characteristics are unknown. An evaluation form or MUA is required, based if necessary on test (cf. MSFC-STD-3029 or ECSS-Q-ST-70-37).
 | F: Flammability | A: Material passed the requirements of Test 1 or Test 4 (or Test 3 for electrical wire insulation) of ECSS-Q-ST-70-21 or of Test 1 (or Test 4 for electrical wire insulation) of NASA-STD-6001B, and/or material is non-flammable (i.e. self-extinguishing) in accordance with ISO 14624-1 or ISO 14624-2. B: Material has a UL 94 flammability rating V-0 or higher (i.e. 5VB or 5VA), or, for electrical wire insulation, a UL 1581 flammability rating of VW-1 or higher (e.g. UL 1581-1160, UL 1685, UL 1666, UL 910), or equivalent. F: Material flammability did not meet the above-mentioned requirements. U: Material for which flammability characteristics are unknown. Justification stated in column 10 for B, F or U.
 | O: Offgassing | Note: Not applicable for ICE Cubes, as the mass < 9072g. P: Material passed the requirements per §4.5.1 of ECSS-Q-ST-70-29. T: Material is covered by testing on equipment level. F: Material failed. Waiver reference stated in column 10. U: Material for which offgassing characteristics are unknown.
 | U: Outgassing | Note: Not applicable for ICE Cubes, as it is a pressurized payload for the ISS. P: Material passed the requirements of ECSS-Q-ST-70-02. Reference of test report stated in column 10. F: The material failed. Waiver reference stated in column 10. U: Material for which outgassing characteristics are unknown.
10 | Justification for approval and comments | Use column 10 for any additional information to obtain ESA approval. E.g. reference to RFAs, reference to justificatory file for materials approved for other space and aeronautical programmes meeting the specific needs of the programme, reference to evaluation reports, waivers, etc.

Sheet: Column 1 Group Numbers
Group | Material type
01 | Aluminium and aluminium alloys
02 | Copper and copper alloys
03 | Nickel and nickel alloys
04 | Titanium and titanium alloys
05 | Steels
06 | Stainless steels
07 | Filler metals: welding, brazing, soldering
08 | Miscellaneous metallic materials
09 | Optical materials
10 | Adhesives, coatings, varnishes
11 | Adhesive tapes
12 | Paints and inks
13 | Lubricants
14 | Potting compounds, sealants, foams
15 | Reinforced plastics (including PCBs)
16 | Rubbers and elastomers
17 | Thermoplastics
18 | Thermoset plastics (including PCBs)
19 | Material aspects of wires and cables
20 | Miscellaneous non-metallic materials, e.g. ceramics
