ISU-Research/Hydra1-Orbital-Greenhouse/Engineering files/Hydra 1 PCB files/Hydra 1 PCB parts/Hydra 1 PCB Part List.xlsx

Sno. | Part | Part Number | Provider | Weblink
1 | Red LEDS *12 | LDR-2835TDRCA-R660 | Alibaba | https://www.alibaba.com/product-detail/Deep-Red-0-5W-SMD-5730_60598454359.html
2 | Blue LEDs *6 | LDR-2835TBCA-R450 | Alibaba | https://www.alibaba.com/product-detail/Deep-Red-0-5W-SMD-5730_60598454359.html
3 | Adafruit Motor Control Board *1 | DRV8833 | digikey | https://www.digikey.fr/product-detail/fr/3297/1528-1795-ND/6419360?so=54452795&so=54452795
4 | Thermistor *1 | 700-DS18B20PAR | Mouser | https://eu.mouser.com/ProductDetail/maxim-integrated/ds18b20+par/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
5 | Molex Connector | 87754-0462 | Molex Connector | https://eu.mouser.com/ProductDetail/molex/87754-0462/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
6 | Resistor -80.6 Ohms *6 | RT0805BRD0780R6L | Mouser | https://eu.mouser.com/ProductDetail/603-RT0805BRD0780R6L?r=603-RT0805BRD0780R6L
7 | Resistor- 120 Ohm*3 | 652-CR0805-FX1200GLF | Mouser | https://eu.mouser.com/ProductDetail/652-CR0805-FX1200GLF?r=652-CR0805-FX1200GLF
8 | Resistor -39 ohm- *6 | 660-RN732ATTD39R0F25 | Mouser | https://eu.mouser.com/ProductDetail/660-RN732ATTD39R0F25?r=660-RN732ATTD39R0F25
9 | Voltage Regulator | 595-TPS79533DCQR | Moser | https://eu.mouser.com/ProductDetail/595-TPS79533DCQR?r=595-TPS79533DCQR
10 | Capacitor-0.0uF *1 |  | Mouser | https://eu.mouser.com/ProductDetail/581-W2A46C103KAT2A?r=581-W2A46C103KAT2A
 |  | 581-W2A46C103KAT2A
11 | Capacitor- 1uF *2 | 581-12066C105KAT2A | Mouser | https://eu.mouser.com/ProductDetail/581-12066C105KAT2A?r=581-12066C105KAT2A
12 | Jumper *4 | CAB 4 G S | Fischer Electronik | http://www.fischerelektronik.de/web_fischer/en_GB/connectors/G07/Jumpers/VA/CAB4GS/index.xhtml
13 | Connector *2 | MK 23 SMD | Fischer Electronik | http://www.fischerelektronik.de/web_fischer/fr/connectors/G02/Connecteurs%20femelles/PR/MK_23_SMD_/index.xhtml
14 | Male Header *2 | MK LP 41 | Fischer Electronik | http://www.fischerelektronik.de/web_fischer/en_GB/connectors/G01/Male%20headers/PR/MK_LP_41_/$productCard/parameters/index.xhtml
15 | White LEDs *3 | 593-VAOL-S2WR4 | Mouser | https://eu.mouser.com/ProductDetail/vcc/vaol-s2wr4/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
16 | Header | 855-M20-8770642R | Mouser | https://eu.mouser.com/ProductDetail/harwin/m20-8770642r/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
17 | Connector *2 | IDSS-02-S-02.00 | Samtec | https://www.samtec.com/products/idss-02-s-02.00
