ISU-Research/Hydra1-Orbital-Greenhouse/Engineering files/Hydra 1 safety data inputs/Experiment Cube #1 (Hydra-1) iss_oe_bio_eclss_tox_submittal 23 May 2018 MFH.xlsx

Sheet: Flight and Contact Info
Please complete each field below and all applicable tabs. Place and hold cursor over boxes with red triangles for detailed instructions. Please submit completed form by email to: |  | jsc-brb-ecls-tox
Date submitted:
Name and number of experiment or hardware: | Hydra-1
Acronym: | N/A
OpNom: | Experiment Cube #1
ISS Hazard System (IHS) record number: | TBD
Kit-level / Assembly-level part number and name:
ISS Module (storage): | Columbus
ISS Module (use): | Columbus
International partner concurrence? | Experiment developed on commercial basis and certified by ESA
Does this experiment involve thermal heating or combustion (e.g. furnace)? | NO
Is information proprietary? If so, please read note below and provide response in the space provided. | NO
Principal Investigator name, title, and affiliation: | Prof Chris Welch - International Space University (ISU)
Contact person: | Mauro Ricci (ICE Cubes Service Project Manager)
Address (building and room number): | Huygensstraat 34 2201 DK Noordwijk The Netherlands
Phone: | +31 6 31744267
Fax:
e-mail: | mauro.ricci@spaceapplications.com
Previous mission information: | N/A
Brief summary of the experiment or conditions of use including process conditions (attach additional sheets as necessary): | The experiment Hydra-1 is a greenhouse based on the LPX module that has been developed at NASA Ames, by Dr Chris McKay. Hydra-1 is developed as an Experiment Cube to be operated inside the ICE Cubes Facility, on board the Columbus module of the ISS. The ICE Cube Facility and the Hydra-1 Experiment Cube will be launched in January 2018. Target launcher is SpaceX-14. The greenhouse has dimensions of 10 cm x 10 cm x 10 cm and it is filled with air. The experiment is conducted at temperature range from 24 degC to 28 degC. About 50 seeds of Arabidopsis will be placed in the sealed growth chamber (consisting of a growth media, light source and growth chamber). The seeds are secured to filter papers supports using a dilute solution of Guar gum. The development of the plants will be observed visually. Specific characterisation of the growth and health of the plants will be provided by regular sampling of the O2 and CO2 levels in the growth chamber. A small amount of stored water will be administered periodically to the plants, according to a predetermined schedule, which will be compared against ground controls. Outcomes from this experiment are looking specifically for differences in health, growth rate and morphology of the developing plants in the reduced gravity and higher radiation environment onboard the ISS. Other variables, such as lighting cycles are also considered in this experiment. Payload data from this experiment is primarily periodic high resolution images of the pl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
Note: This distribution list/mailbox has a limited, protected distribution to only authorized NASA specialists responsible for reviewing the submitted data for toxicology, biological safety, and ISS environmental control/life support system impacts. Based upon review/conclusions from these specialists, a flight safety Hazardous Material Summary Table (HMST) will be prepared and provided back to the submitter for inclusion of this HMST within their flight safety data package. (Reference: SSP 30599 - Safety Review Process, JSC 27472 - Requirements for Submission of Data Needed for Toxicological Assessment of Chemicals to be Flown on Manned Spacecraft, JSC 63828 - BioSafety Review Board Operations and Requirements Document, and JSC-66869 - Guidelines for the Assessment of Chemicals and Materials for Impacts to Environmental Control and Life Support Systems and Habitable Volumes of Crewed Spacecraft). If any information within this form is considered proprietary/limited rights, then the submitter shall clearly identify or label any information as such within this form and within the transmittal email subject and body. If necessary, this file may also be password protected prior to submittal, with the password sent via separate email or via other methods (as coordinated with NASA specialists).

Sheet: Non-biological Materials
The following section is to be completed for non-biological components, including all liquids, gels, particles, or gasses contained in the payload or system.
ID Label | Chemical / Reaction Product | Experiment Subsystem | Part # of Subsystem | Maximum Concentration |  |  | Maximum # of Samples | Maximum Amount / Sample | pH of Solution | Particle Size or Size Range | Sample Surface Area | Vapor Pressure, Partial Pressure, and Volume of Gas | Solubility in Water and Henry's Law Constant | Thermal Stability | Known Reactive Hazards | Additional Material Characterization
1 | DESAMETHASONE | Greenhouse | N/A | 30 micromolar (water solution) |  |  | 1 reservoir of the solution | 0.6 mg | 5.8 | N/A | N/A | N/A | 89 mg/L (at 25 °C) 7.2X10-8 atm-cu m/mole | Melting point 262-264 deg C |  | Safety Data Sheet attached
2 | Estradiol | Greenhouse | N/A | 2 micromolar (water solution) |  |  | 1 reservoir of the solution | 0.2 ug | 5.8 | N/A | N/A | N/A |  |  |  | Safety Data Sheet attached
3 | Gaur Gum | Greenhouse | N/A | Dilute solution |  |  | applied in thin layer to each of 50 seeds | ~1 ug | N/A | N/A | N/A | N/A |  |  |  | Safety Data Sheet attached Gaur gum has been used in ISS plant payloads before.
 | Basal Salts Mixtures: the liquid stocks are a mixture of "M0654 – Murashige and Skoog basal salt macronutrient solution" and "M0529 – Murashige and Skoog basal salt micronutrient solution." Each of these are at a 10X concentration and are diluted to 0.5X and buffered to pH 5.8 for the final liquid media. |  |  |  |  |  | In solution | 2.2 grams | N/A | N/A | N/A | N/A
 | M5524 – Murashige and Skoog basal salt mixture (MS)
 | M0654 – Murashige and Skoog basal salt macronutrient solution
 | M0529 – Murashige and Skoog basal salt micronutrient solution
 |  |  |  | (mg/L) M5524 | (mg/L) M0654 | (mg/L) M0529
 | Ammonium nitrate |  |  | 1650 | 1650
 | Boric acid |  |  | 6.2 |  | 6.2
 | Calcium chloride anhydrous |  |  | 332.2 | 332.2
 | Cobalt chloride • 6H2O |  |  | 0.025 |  | 0.025
 | Cupric sulfate • 5H2O |  |  | 0.025 |  | 0.025
 | Na2EDTA |  |  | 37.26 |  | 37.26
 | Ferrous sulfate • 7H2O |  |  | 27.8 |  | 27.8
 | Magnesium sulfate |  |  | 180.7 | 180.7
 | Manganese sulfate • H2O |  |  | 16.9 |  | 16.9
 | Molybdic acid (sodium salt) • 2H2O |  |  | 0.25 |  | 0.25
 | Potassium iodide |  |  | 0.83 |  | 0.83
 | Potassium nitrate |  |  | 1900 | 1900
 | Potassium phosphate monobasic |  |  | 170 | 170
 | Zinc sulfate • 7H2O |  |  | 8.6 |  | 8.6
 | Grams of powder to prepare 1 L |  |  | 4.3 | n/a | n/a
 | pH 1 0.5 at room temperature |  |  | 3.9 | 4.3 | 3.2

Sheet: Biological Materials
The following section is to be completed for all biological materials. If recombinant DNA or RNA are to be used, please complete the last section also.
Identification of Material | Origin of Biological Material | Maximum Concentration per Sample | Pathogenicity | ATCC #, Strain, and Designation | Viral Presence in Cells of Human Origin | Standard Biosafety Level (BSL) if known | Maximum # Samples | Maximum Amount Microbiological Agents per Sample and Subsystem | Additional Information
Arabidopsis Columbia seeds, wild type | NASA Ames seeds |  | none |  | n/a | none | 50 seeds | 50 seeds in the Hydra 1 cube | This plant (Arabidopsis columbia) has flown on ISS many times and is routinely used at NASA Ames
Arabidopsis Columbia seeds, transgenic | UC Berkeley |  | none |  | n/a | none | 50 seeds | 50 seeds in the Hydra 1 cube | These seeds will be from Arabidopsis columbia strains from NASA Ames that have been modified recombinant DNA as described in the next section. The DNA sequence is stably integrated into the host plant genome and does not require extra BSL training or clearance.

Sheet: Recombinant DNA and RNA
The following section is to be completed ONLY if recombinant DNA or RNA will be used.
Identification of Material | Origin of Biological Material | Recombinant DNA or RNA | Type(s) of Vectors and Viral Replication Capacity | Use of Defective DNA/RNA with Helper Virus | Size of Insert/ Total Genome | Nature of Inserted Sequence | Inserts Codes for Known Oncogene or Toxin | Integration of Inserted DNA into Host Genome | Protein(s) Produced | Type(s) of Host | Alteration of Host Range Resulting from Research | Enhancement of Agent Virulence | Research Effects on Agent Transmissibility | Staff Training for Safe Handling of Agent | Medical Surveillance Requirements/ Recommendations | Immunization Requirements/ Recommendations
DNA integrated into transgenic plant genome | E. coli, A. tumefaciens | DNA | pX7 plasmid, pOpOff2 plasmid both with CMV 35S promoter and terminator control |  | Insert size 1 kb | Inserted sequence allows RNAi knockdown of phytoene desaturase gene upon induction with a particular chemical. |  | DNA integrated into Arabidopsis Thaliana Col-0 host genome | N/A | Arabidopsis thaliana Col-0 | N/A | N/A | N/A | N/A | N/A | N/A
