ISU-Research/Hydra1-Orbital-Greenhouse/Engineering files/Hydra 1 Step files/hydra1 PCB Assembly.STEP

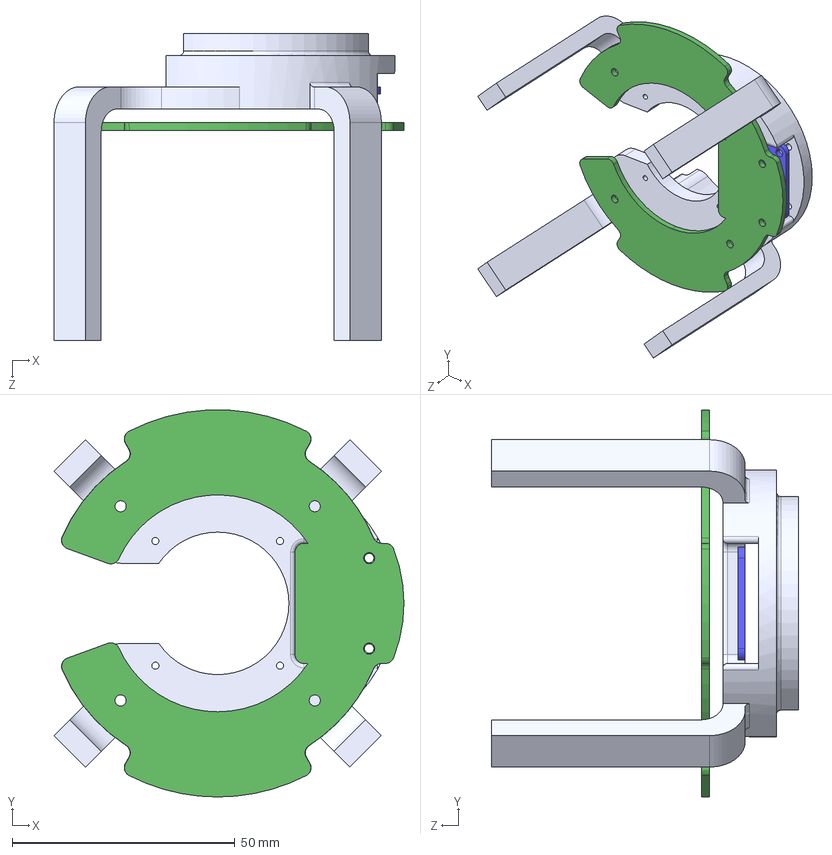
[picture p57: CAD file, 2020-06-15]
Engineering files/Hydra 1 Step files/hydra1 PCB Assembly.STEP
78.6 x 86.9 x 69.0 mm
Support Plate - Holes DFM (1)
PCBUpdatedv1
