ISU-Research/Hydra1-Orbital-Greenhouse/Engineering files/Hydra 1 Step files/Hydra1PCBUpdated.stp

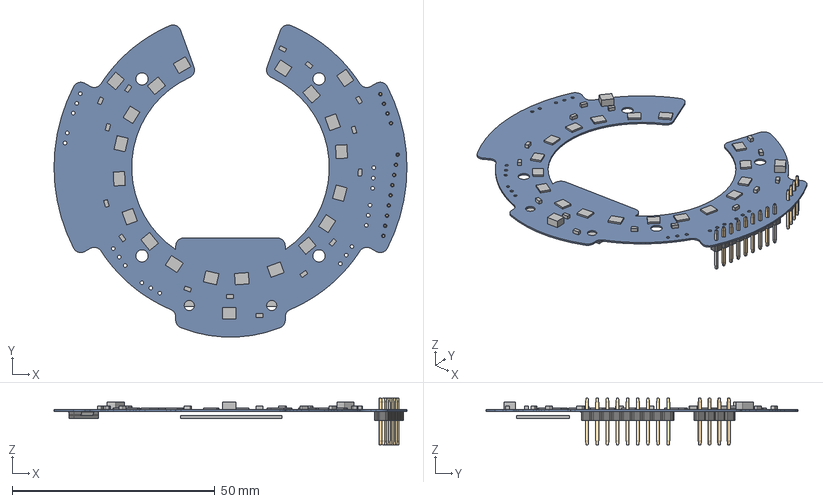
[picture p58: CAD file, 2020-06-15]
Engineering files/Hydra 1 Step files/Hydra1PCBUpdated.stp
87.0 x 76.9 x 11.5 mm
Board
Extruded
Extruded_1
Extruded_2
Extruded_3
Extruded_4
Extruded_5
Extruded_6
Extruded_7
Extruded_8 x 2
Extruded_9
Extruded_10
Extruded_11
Extruded_12
Extruded_13
Extruded_14
Extruded_15
Extruded_16
Extruded_17
Extruded_18
Extruded_19
Extruded_20
Extruded_21
Extruded_22
Extruded_23
Extruded_24
Extruded_25
Extruded_26
Extruded_27
Extruded_28
Extruded_29
Extruded_30
Extruded_31
Extruded_32
Extruded_33
Extruded_34
Extruded_35
Header, Male, 2.54mm, 1x4
Open_CASCADE_STEP_translator_6.8_2.1.1
Lead x 5
Tab
Header, Male, 2.54mm, 1x3 x 3
