ISU-Research/Hydra1-Orbital-Greenhouse/Engineering files/Hydra 1 Step files/Hydra 1 Bus structure.STEP

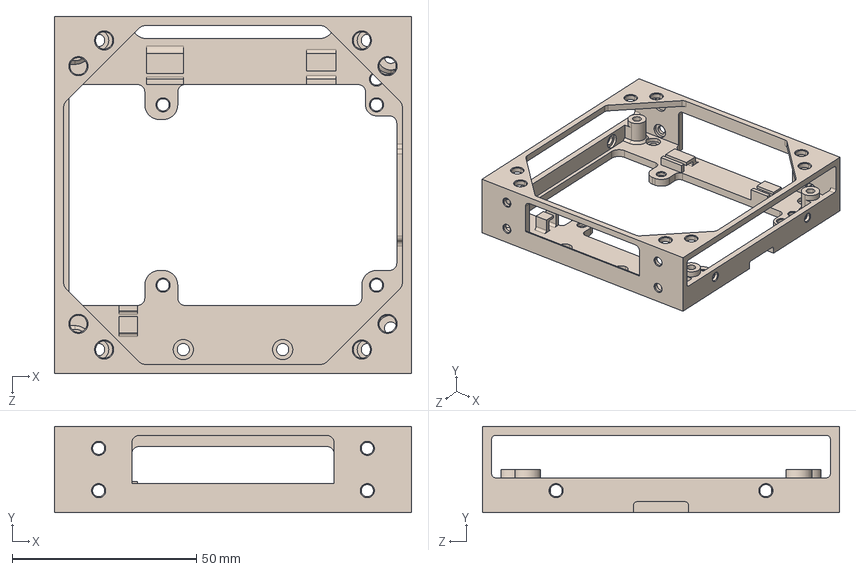
[picture p59: CAD file, 2020-06-15]
Engineering files/Hydra 1 Step files/Hydra 1 Bus structure.STEP
97.0 x 23.5 x 97.0 mm
