ISU-Research/Hydra1-Orbital-Greenhouse/Image analysis/Ground/results1573142079.301229/ImageAnalysis_v1-6_BackgroundOutput.csv

location | Plant type | Image | Time (s) | Background Paper: Index 4 | Background Metal: Index 4
ground | WT | Img-2018-12-19 21_47_42.889672_cut.png | 0.2916666666666667 | 0.33793103448275863 | 0.33653846153846156
ground | WT | Img-2018-12-20 13_47_53.669176_cut.png | 0.9583449074074074 | 0.336283185840708 | 0.3365200764818356
ground | WT | Img-2018-12-21 05_48_04.444415_cut.png | 1.6256481481481482 | 0.33653846153846156 | 0.3365570599613153
ground | WT | Img-2018-12-21 21_48_15.342554_cut.png | 2.2923263888888887 | 0.3364140480591497 | 0.3365019011406844
ground | WT | Img-2018-12-22 13_48_25.492088_cut.png | 2.9590046296296295 | 0.33620689655172414 | 0.33646616541353386
ground | WT | Img-2018-12-23 05_48_36.307075_cut.png | 3.6256828703703703 | 0.3361774744027304 | 0.3365200764818356
ground | WT | Img-2018-12-23 21_48_47.273996_cut.png | 4.292361111111111 | 0.3361921097770154 | 0.33643122676579923
ground | WT | Img-2018-12-24 13_48_58.081241_cut.png | 4.959039351851852 | 0.3361629881154499 | 0.33646616541353386
ground | WT | Img-2018-12-25 05_49_09.011679_cut.png | 5.626342592592593 | 0.3362218370883882 | 0.33643122676579923
ground | WT | Img-2018-12-25 21_49_19.136099_cut.png | 6.293020833333333 | 0.3361774744027304 | 0.33648393194706994
ground | WT | Img-2018-12-26 13_49_30.211937_cut.png | 6.959710648148148 | 0.3361629881154499 | 0.33646616541353386
ground | WT | Img-2018-12-27 05_49_41.395611_cut.png | 7.626388888888889 | 0.3361629881154499 | 0.3365200764818356
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
ground | TG | Img-2019-01-01 16_55_42.704226_cut.png | 13.088888888888889 | 0.3316412859560068 | 0.3305084745762712
ground | TG | Img-2019-01-02 08_55_56.453749_cut.png | 13.755567129629629 | 0.3353028064992615 | 0.3339160839160839
