ISU-Research/Hydra1-Orbital-Greenhouse/Image analysis/Flight/results1573142098.49226/ImageAnalysis_v1-6_BackgroundOutput.csv

location | Plant type | Image | Time (s) | Background Paper: Index 4 | Background Metal: Index 4
flight | WT | Img-2018-12-19 09_37_02.406660_cut.png | 0.9590046296296296 | 0.34673366834170855 | 0.34833659491193736
flight | WT | Img-2018-12-20 01_37_41.250477_cut.png | 1.6257175925925926 | 0.3344947735191638 | 0.33271375464684017
flight | WT | Img-2018-12-20 17_38_20.705614_cut.png | 2.2930555555555556 | 0.33436532507739936 | 0.33238636363636365
flight | WT | Img-2018-12-21 09_38_59.652742_cut.png | 2.9597569444444445 | 0.3344768439108062 | 0.3333333333333333
flight | WT | Img-2018-12-22 01_39_38.617931_cut.png | 3.6270949074074075 | 0.3333333333333333 | 0.3333333333333333
flight | WT | Img-2018-12-22 17_40_17.296371_cut.png | 4.29443287037037 | 0.32222222222222224 | 0.33184855233853006
flight | WT | Img-2018-12-23 09_40_56.277043_cut.png | 4.961145833333333 | 0.3333333333333333 | 0.3323615160349854
flight | WT | Img-2018-12-24 01_41_35.710161_cut.png | 5.628483796296297 | 0.3333333333333333 | 0.33254716981132076
flight | WT | Img-2018-12-24 17_42_14.649429_cut.png | 6.295821759259259 | 0.3343949044585987 | 0.3333333333333333
flight | WT | Img-2018-12-25 09_42_54.447066_cut.png | 6.962534722222222 | 0.3333333333333333 | 0.3323529411764706
flight | WT | Img-2018-12-26 01_43_33.579234_cut.png | 7.629872685185185 | 0.3333333333333333 | 0.3322734499205087
flight | WT | Img-2018-12-26 17_44_12.587626_cut.png | 8.297210648148148 | 0.3333333333333333 | 0.3324175824175824
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
flight | TG | Img-2019-01-03 03_50_21.868312_cut.png | 15.718055555555555 | 0.3366733466933868 | 0.3381294964028777
flight | TG | Img-2019-01-03 19_51_01.522348_cut.png | 16.38539351851852 | 0.3368421052631579 | 0.3383742911153119
flight | TG | Img-2019-01-04 11_51_40.223993_cut.png | 17.05210648148148 | 0.336734693877551 | 0.33793103448275863
flight | TG | Img-2019-01-05 20_11_28.602960_cut.png | 18.399305555555557 | 0.335423197492163 | 0.33648393194706994
flight | TG | Img-2019-01-06 12_12_07.463971_cut.png | 19.066643518518518 | 0.33505154639175255 | 0.33595284872298625
flight | TG | Img-2019-01-07 04_12_46.611331_cut.png | 19.733356481481483 | 0.335 | 0.33583489681050654
