ISU-Research/Hydra1-Orbital-Greenhouse/Image analysis/Flight/results1573142098.49226/ImageAnalysis_v1-6_output.csv

location | Plant type | Image | Time (s) | Index 4 | Pixel Count
flight | WT | Img-2018-12-21 09_38_59.652742_paste.png | 2.9597569444444445 | 0.35251798561151076 | 21
flight | WT | Img-2018-12-22 01_39_38.617931_paste.png | 3.6270949074074075 | 0.3421686746987952 | 200
flight | WT | Img-2018-12-22 17_40_17.296371_paste.png | 4.29443287037037 | 0.350292925508362 | 544
flight | WT | Img-2018-12-23 09_40_56.277043_paste.png | 4.961145833333333 | 0.36103151862464183 | 1269
flight | WT | Img-2018-12-24 01_41_35.710161_paste.png | 5.628483796296297 | 0.3647342995169082 | 1849
flight | WT | Img-2018-12-24 17_42_14.649429_paste.png | 6.295821759259259 | 0.36199095022624433 | 2266
flight | WT | Img-2018-12-25 09_42_54.447066_paste.png | 6.962534722222222 | 0.36538461538461536 | 2733
flight | WT | Img-2018-12-26 01_43_33.579234_paste.png | 7.629872685185185 | 0.3629242819843342 | 3161
flight | WT | Img-2018-12-26 17_44_12.587626_paste.png | 8.297210648148148 | 0.36217948717948717 | 4317
flight | WT | Img-2018-12-27 09_44_51.706000_paste.png | 8.963923611111111 | 0.3600867678958785 | 5010
flight | WT | Img-2018-12-28 19_45_07.533330_paste.png | 10.381226851851851 | 0.36612647084568156 | 5518
flight | WT | Img-2018-12-29 11_45_46.413167_paste.png | 11.047939814814814 | 0.3692722371967655 | 5744
flight | WT | Img-2018-12-30 03_46_25.447414_paste.png | 11.715277777777779 | 0.37050359712230213 | 5401
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
flight | TG | Img-2019-01-06 12_12_07.463971_paste.png | 19.066643518518518 | 0.33852140077821014 | 2031
flight | TG | Img-2019-01-07 04_12_46.611331_paste.png | 19.733356481481483 | 0.3386408909815284 | 1506
