ISU-Research/Hydra1-Orbital-Greenhouse/Image analysis/Flight/results1573142098.49226/histograms/Img-2018-12-21 09_38_59.652742_hist.jpg

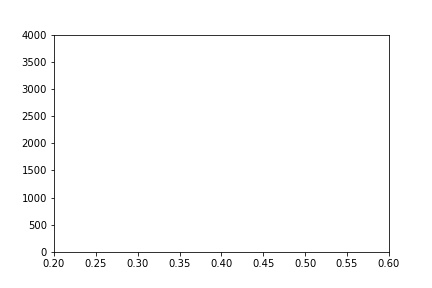
Image analysis/Flight/results1573142098.49226/histograms/Img-2018-12-21 09_38_59.652742_hist.jpg
