ISU-Research/Hydra1-Orbital-Greenhouse/Image analysis/Flight/results1573142098.49226/histograms/Img-2018-12-26 01_43_33.579234_hist.jpg

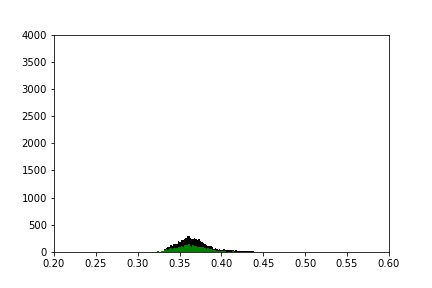
Image analysis/Flight/results1573142098.49226/histograms/Img-2018-12-26 01_43_33.579234_hist.jpg
