ISU-Research/Hydra1-Orbital-Greenhouse/Image analysis/Ground/results1573142079.301229/histograms/Img-2018-12-30 16_55_15.043159_hist.jpg

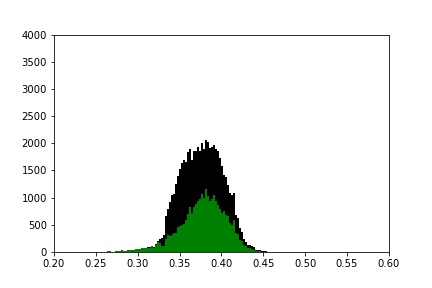
Image analysis/Ground/results1573142079.301229/histograms/Img-2018-12-30 16_55_15.043159_hist.jpg
