ISU-Research/Hydra1-Orbital-Greenhouse/Image analysis/Ground/results1573142079.301229/histograms/Img-2019-01-01 00_55_33.471429_hist.jpg

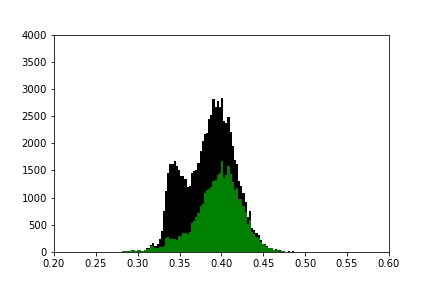
Image analysis/Ground/results1573142079.301229/histograms/Img-2019-01-01 00_55_33.471429_hist.jpg
