ISU-Research/Hydra1-Orbital-Greenhouse/Image analysis/Ground/results1573142079.301229/histograms/Img-2019-01-01 16_55_42.704226_hist.jpg

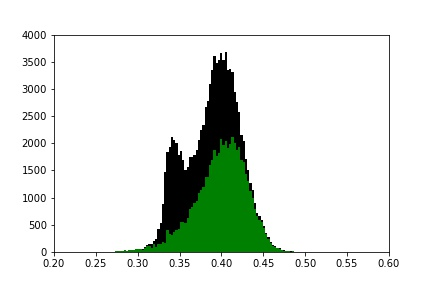
Image analysis/Ground/results1573142079.301229/histograms/Img-2019-01-01 16_55_42.704226_hist.jpg
