ISU-Research/Hydra1-Orbital-Greenhouse/Image analysis/Ground/results1573142079.301229/histograms/Img-2019-01-02 08_55_56.453749_hist.jpg

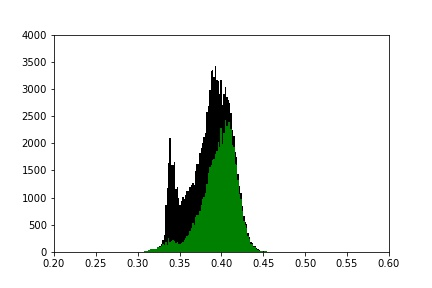
Image analysis/Ground/results1573142079.301229/histograms/Img-2019-01-02 08_55_56.453749_hist.jpg
