ISU-Research/Hydra1-Orbital-Greenhouse/Engineering files/Hydra 1 PCB files/Hydra 1 PCB Schematics.pdf

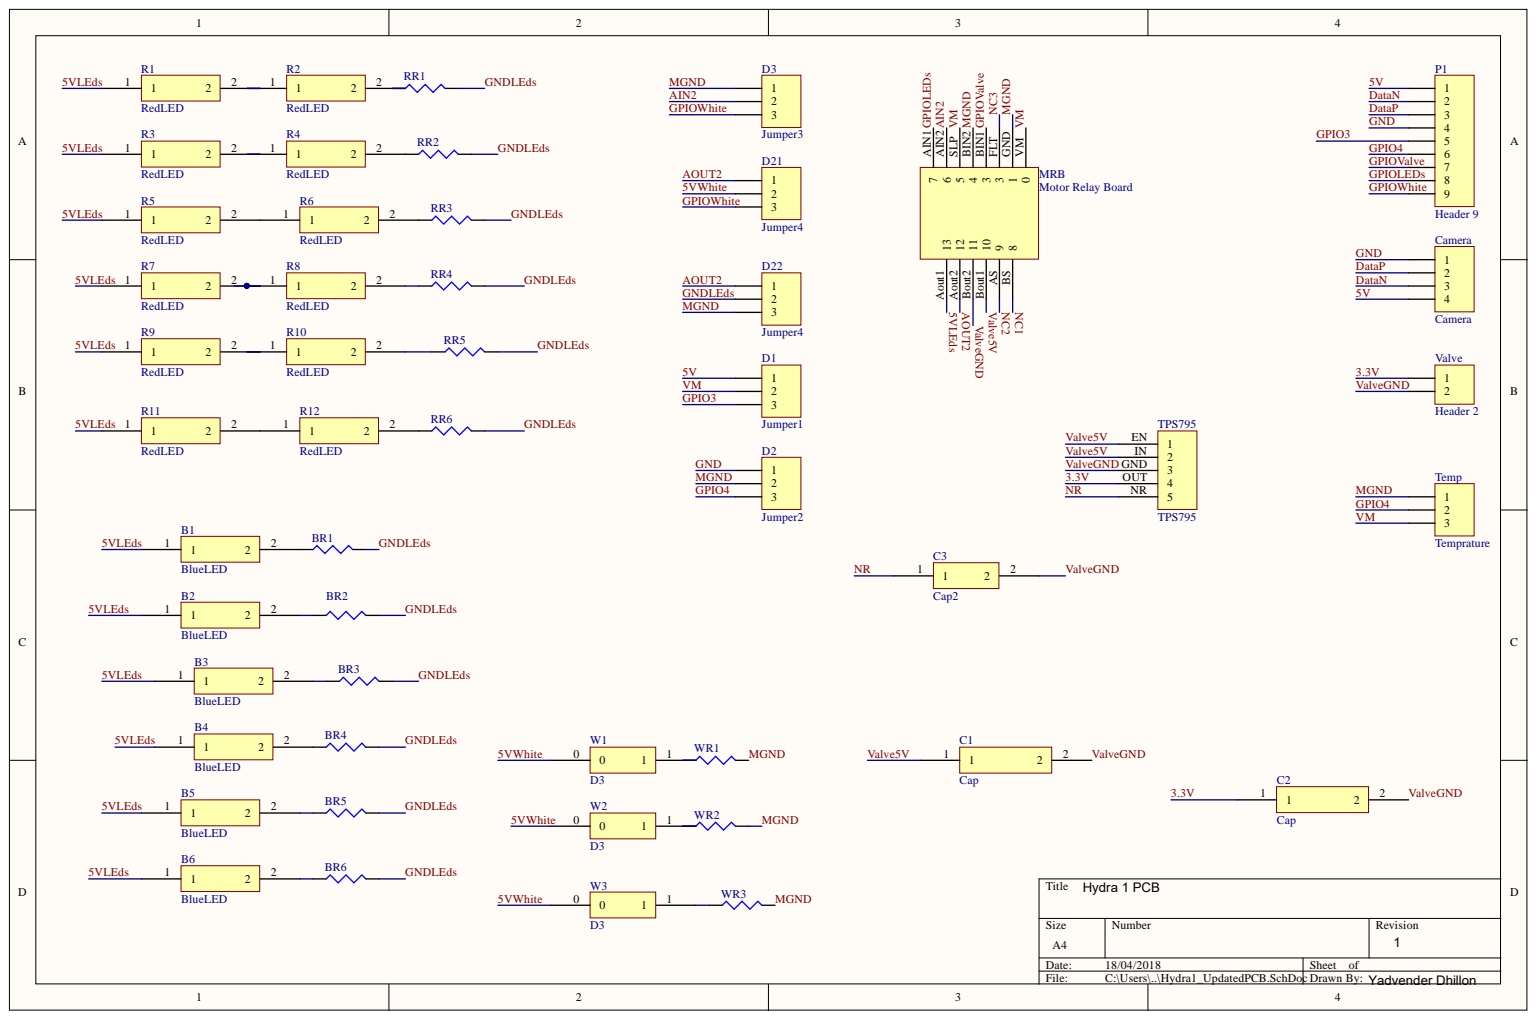
[picture p66: page 1]

0 VM 1 GND 3 FLT 3 BIN1 4 BIN2 5 SLP 6 AIN2 7 AIN1

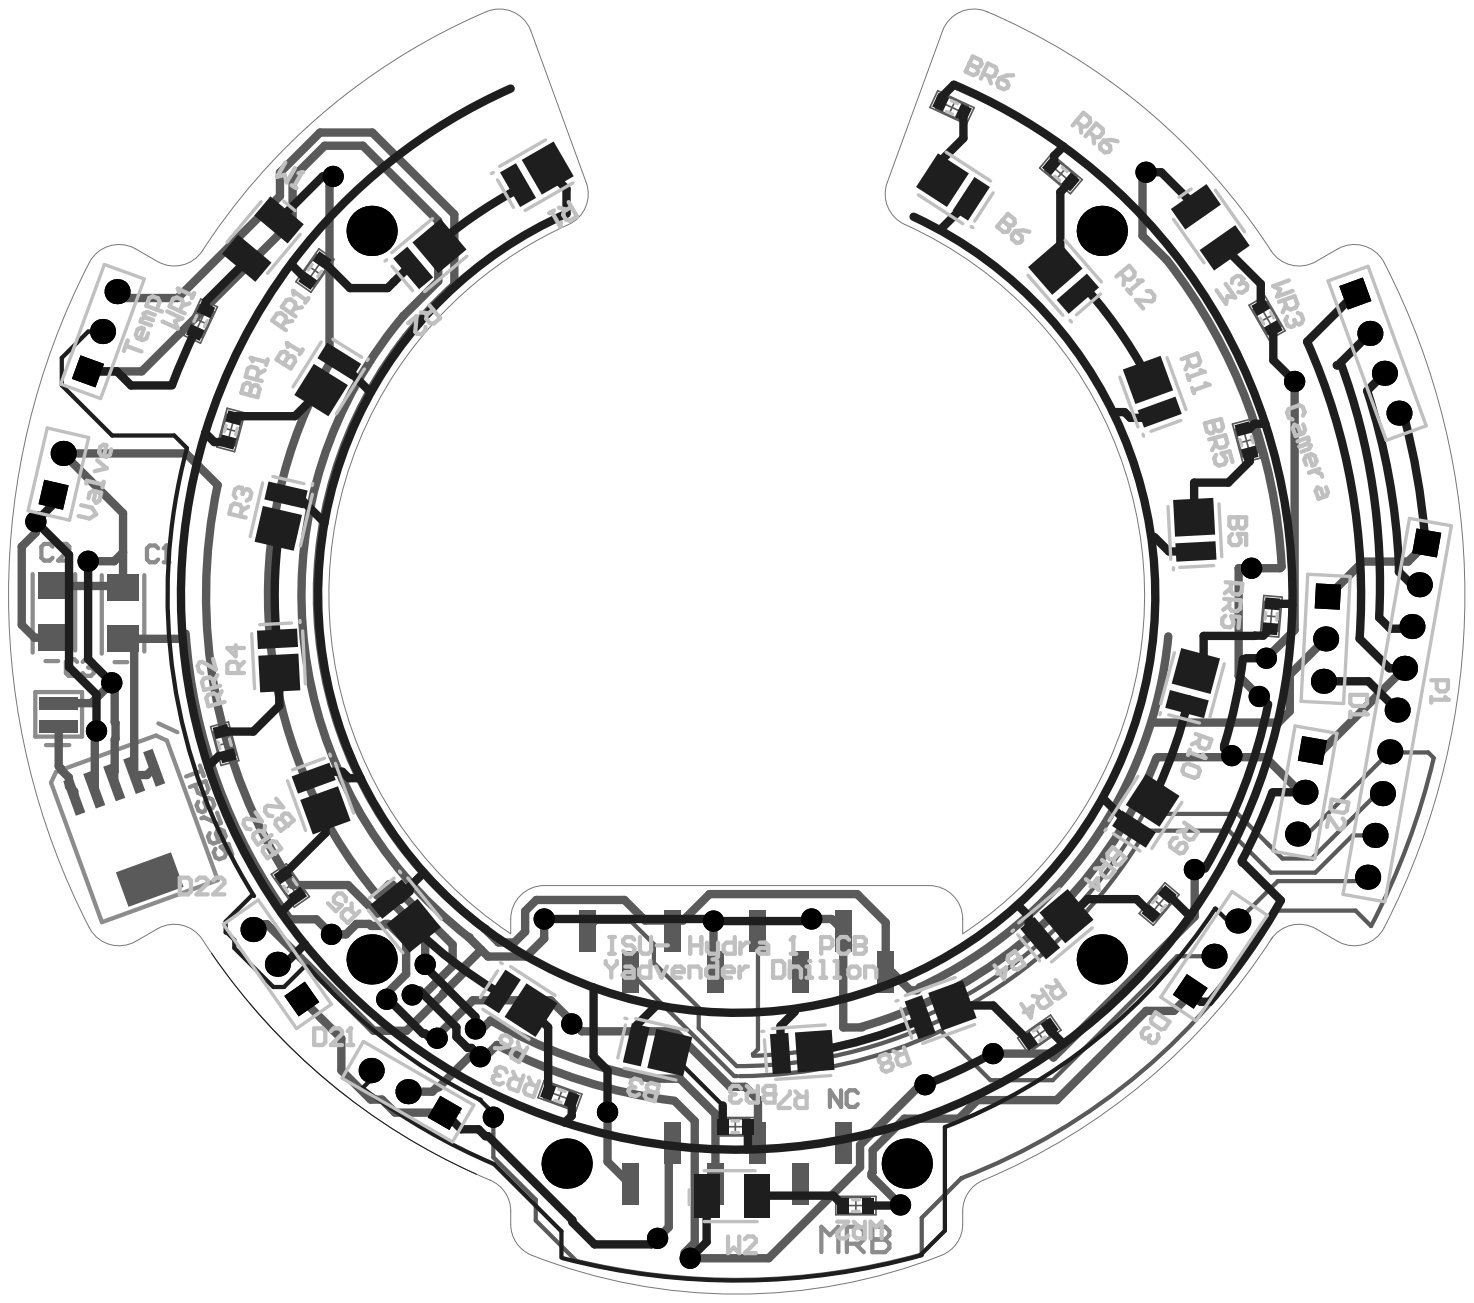
[picture p67: page 2]
